GeoKrom/NTUA-Mechatronic-Systems-course/Project/Images/Τροχοφόρο_4.jpg

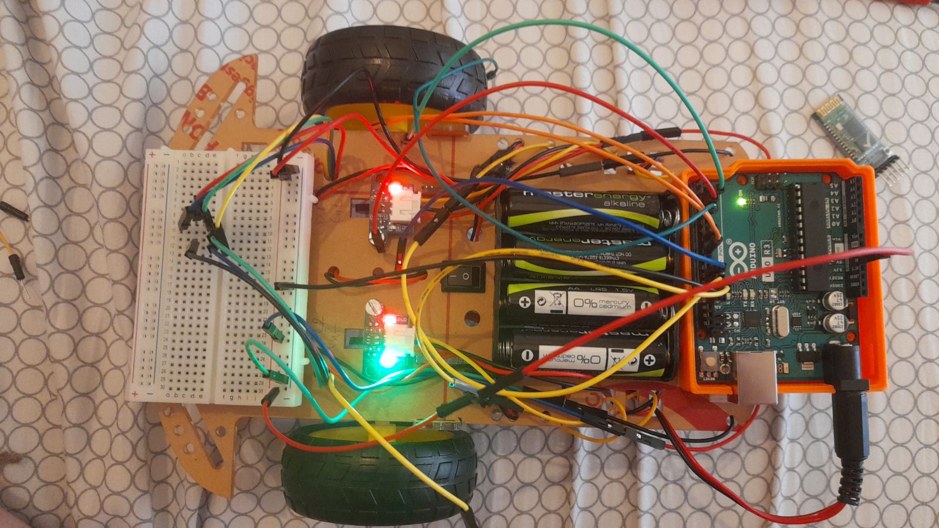
Project/Images/Τροχοφόρο_4.jpg
