GeoKrom/NTUA-Mechatronic-Systems-course/Project/Images/Τροχοφόρο_3.jpg

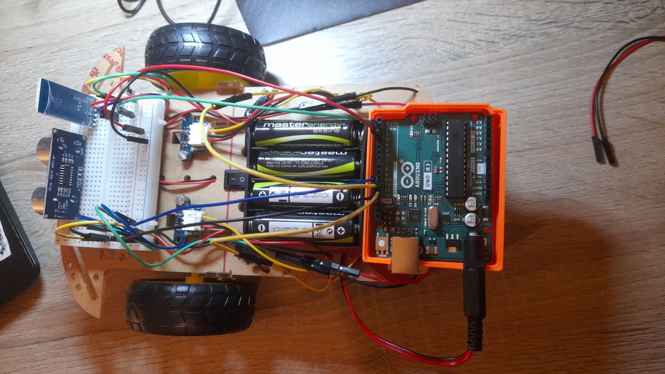
Project/Images/Τροχοφόρο_3.jpg
