GeoKrom/NTUA-Mechatronic-Systems-course/Project/Images/diagrams.pptx

PWM Enable Signal

Arduino

+

−

e

L298N Driver

DC Motors

ω_(dc)

Plant

θ

v,ω

Encoders

Εντολές από Βραχίονα

Sonar

## Slide 2

Bluetooth

Driver PCA 9685

Arduino

MG90S Micro Servo Motors

θ_(ms)

Plant

p_E

Εντολές Ταχύτητας Οχήματος

Εντολές

Εντολές Θέσεις βραχίονα

Bluetooth

Joystick

Εντολές προς Τροχοφόρο

Forward Kinematics

## Slide 3

v,ω

q

q

v_d ,ω_d

+

−

e

PID
Controller

F_Σ , Μ_Σ

Dynamics

Kinematics
∫

θ

## Slide 4

ω_(r,d)

+

−

PID
Controller

DC
Motor 1

n

ω_r

Encoder 1

q_d

v_d ,ω_d

Inverse
Kinematics

Compute
ω_r , ω_l

Compute
v, ω

Unicycle
Model

q

PID
Controller

ω_l

ω_(l,d)

+

−

DC
Motor 2

n

Encoder 2
