GeoKrom/NTUA-Mechatronic-Systems-course/Project/Παρουσίαση Εργασίας Μηχανοτρονικά Συστήματα.pdf

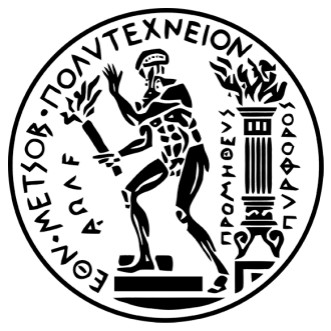
[picture p3: figure]

## Τηλεχειρισμός Κινητού Ρομποτικού Βραχίονα

ΔΠΜΣ Συστήματα Αυτοματισμού

Μηχανοτρονικά Συστήματα

Ομάδα 2:
Γεώργιος Κασσαβετάκης
Άγγελος Κουσάνας
Κωνσταντίνος Μανώλης

Ομάδα 6:
Γεώργιος Κρομμύδας
Λάμπης Παπακώστας

Μηχανοτρονικά Συστήματα, Δευτέρα 22 Μαΐου 2017

# Δομή Παρουσίασης

1. Κίνητρο
2. Σχεδιασμός
3. Κατασκευή Επιμέρους Συστημάτων
4. Συγχώνευση Κατασκευών
5. Αποτελέσματα
6. Εμπόδια - Δυσκολίες
7. Συμπεράσματα
ΟΜΆΔΕΣ 2 - 6 | 2

# 1. Κίνητρο

- Εξοικείωση με την εκπαιδευτική πλατφόρμα Arduino και μηχανοτρονικών συστημάτων.
- Εφαρμογή και αφομοίωση μεθοδολογιών που αποκτήθηκαν κατά τη φοίτηση στο παρόν ΔΠΜΣ.
- Μηχανοτρονικές έννοιες.
- Ανάπτυξη λογισμικού σε RTOS.
- Θεωρία Ελέγχου.
- Εξοικείωση με ρομποτικές διατάξεις.
- Καθορισμός προδιαγραφών συστήματος (υλικά, κόστη, κατανομή χρόνου).

# Ρομποτικός Βραχίονας

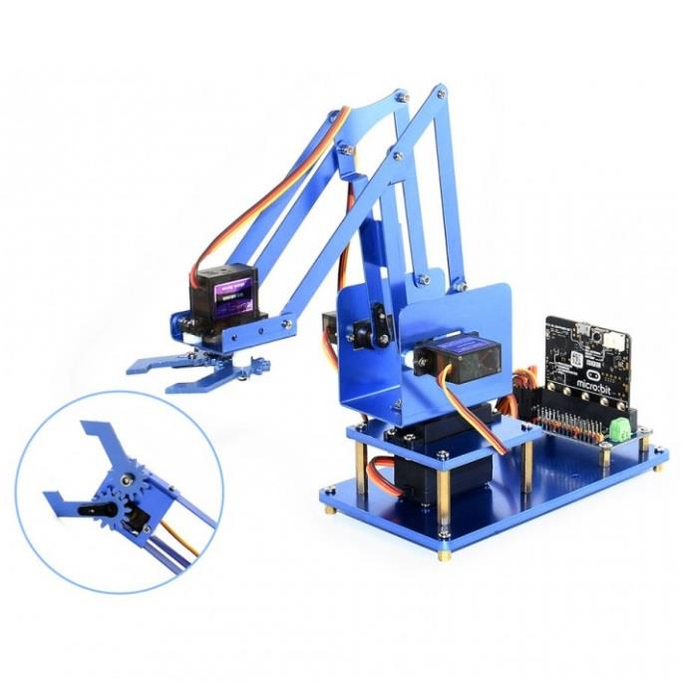
[picture p4: figure]

•Μηχανισμός τεσσάρων μελών

- Τέσσερις (4) servo – κινητήρες

•Τελικό στοιχείο δράσης

•Τηλεχειρισμός με bluetooth

•Έλεγχος στο χώρο των αρθρώσεων

•Έλεγχος στον καρτεσιανό χώρο

# Τροχοφόρο Ρομπότ

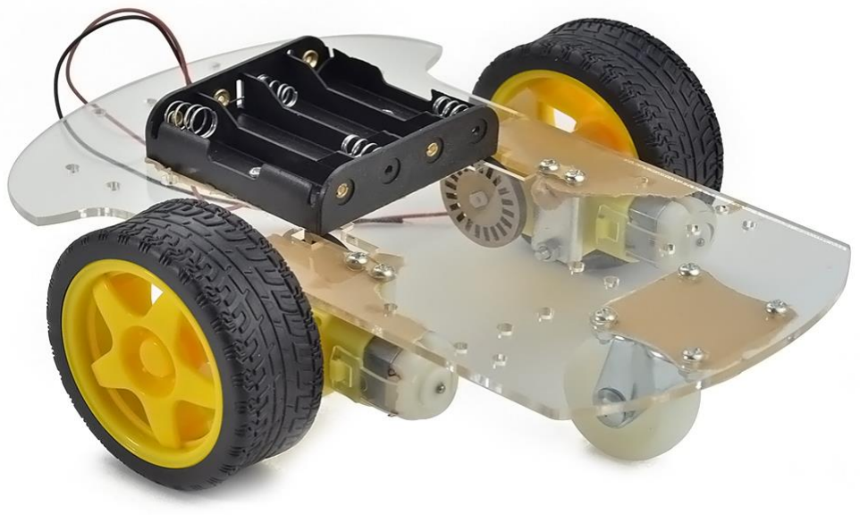
[picture p5: figure]

- Unicycle Model.
- Αποτελείται από δύο DC κινητήρες με

μειωτήρα.

- Σκελετός από ακριλικό υλικό.
- Χρήση Encoder για έλεγχο ταχύτητας.
- Χρήση Ultra Sonar για ανίχνευση

εμποδίων.

# Υλικό Ρομποτικού Βραχίονα

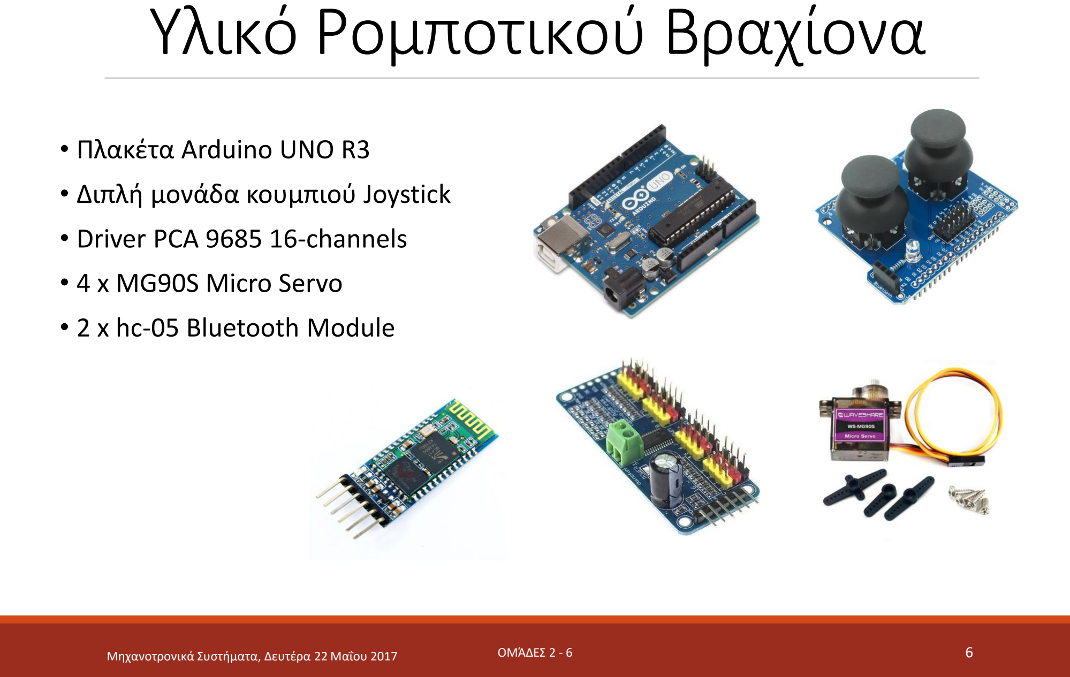
[picture p6: page 6]

- Πλακέτα Arduino UNO R3
- Διπλή μονάδα κουμπιού Joystick
- Driver PCA 9685 16-channels
- 4 x MG90S Micro Servo
- 2 x hc-05 Bluetooth Module

# Υλικό Τροχοφόρου

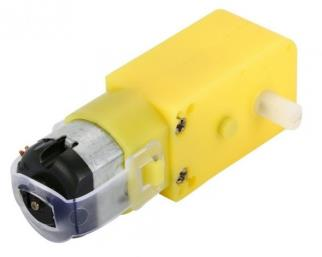
[picture p7: figure]

- Πλακέτα Arduino Uno Rev 3.
- Dual Motor Driver Module L298N.

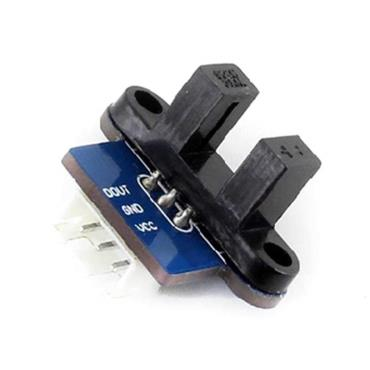
[picture p8: figure]

- 2xDC Gear Motor TT - 125 RPM.

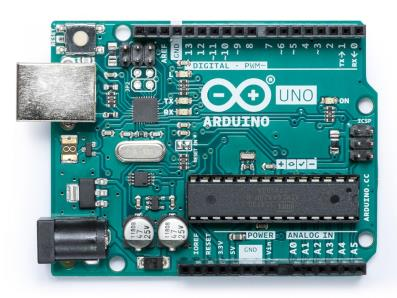
[picture p9: figure]

- 2xWaveshare Photo Interrupter Sensor.

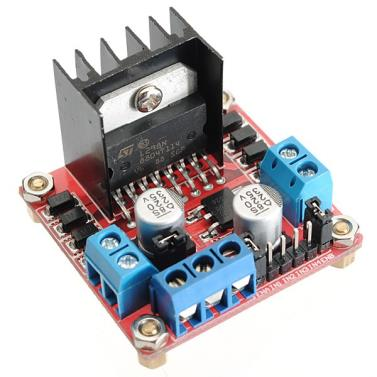
[picture p10: figure]

- Ultrasonic Sensor - Ranging Detector 2 -

400cm HC-SR04.

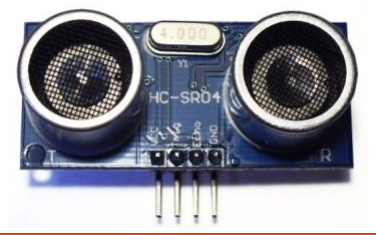
[picture p11: figure]

# 2.Σχεδιασμός

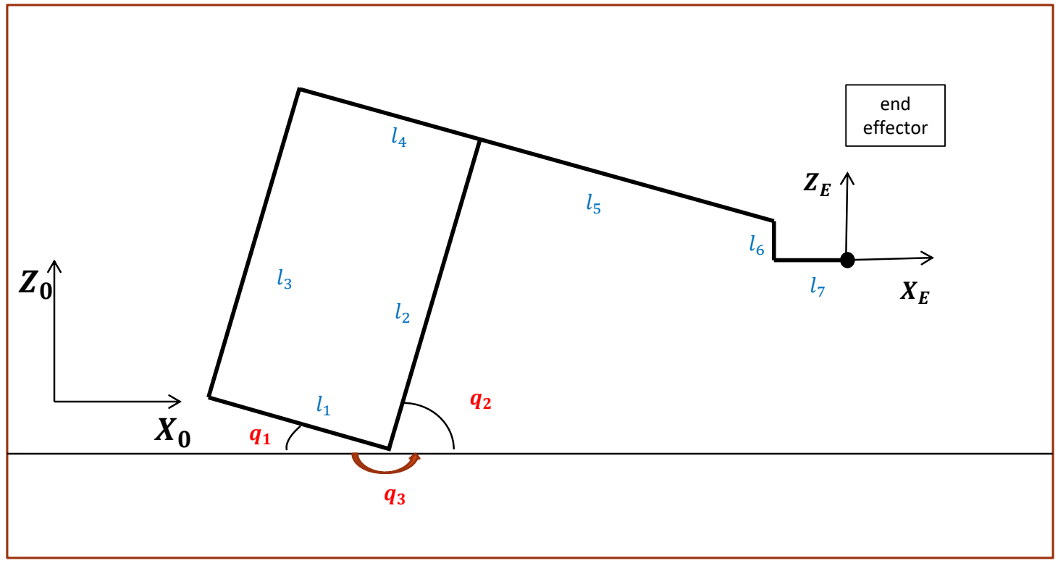
[picture p12: figure]
end effector

# Μοντελοποίηση Ρομποτικού Βραχίονα

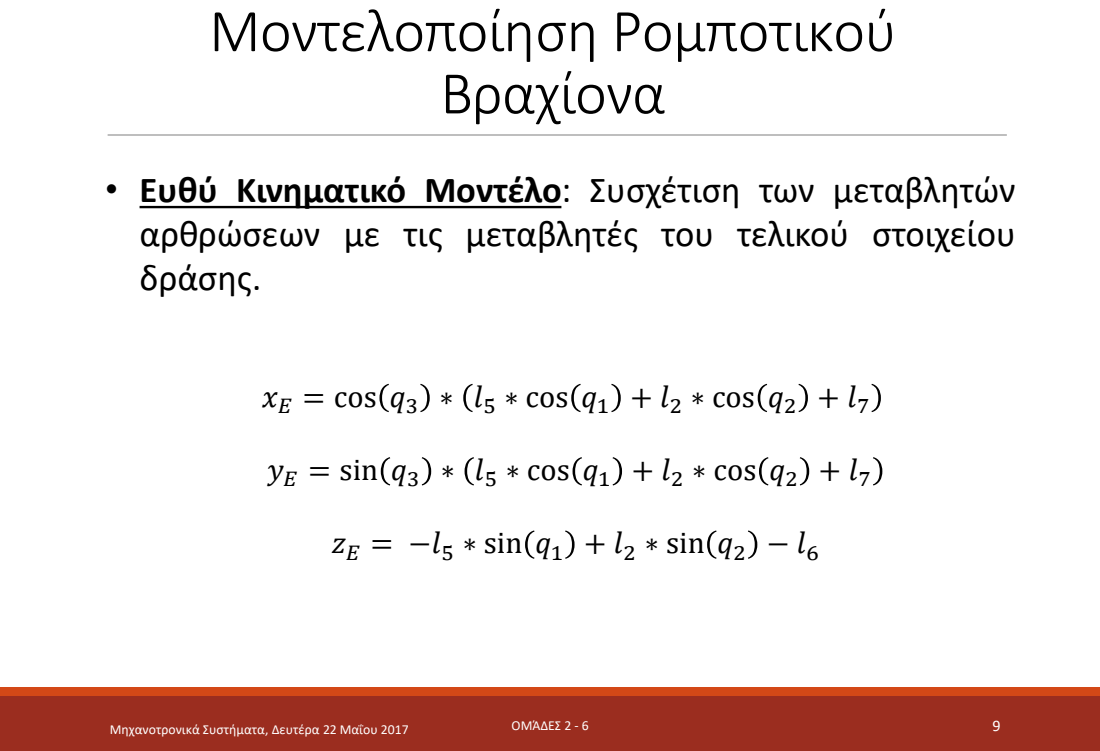
[picture p13: page 9]

• Ευθύ Κινηματικό Μοντέλο: Συσχέτιση των μεταβλητών
αρθρώσεων με τις μεταβλητές του τελικού στοιχείου
δράσης.

xE = cos q3 ∗ l5 ∗ cos q1 + l2 ∗ cos q2 + l7

yE = sin q3 ∗ l5 ∗ cos q1 + l2 ∗ cos q2 + l7

zE = −l5 ∗ sin q1 + l2 ∗ sin q2 − l6

# Μοντελοποίηση Ρομποτικού Βραχίονα

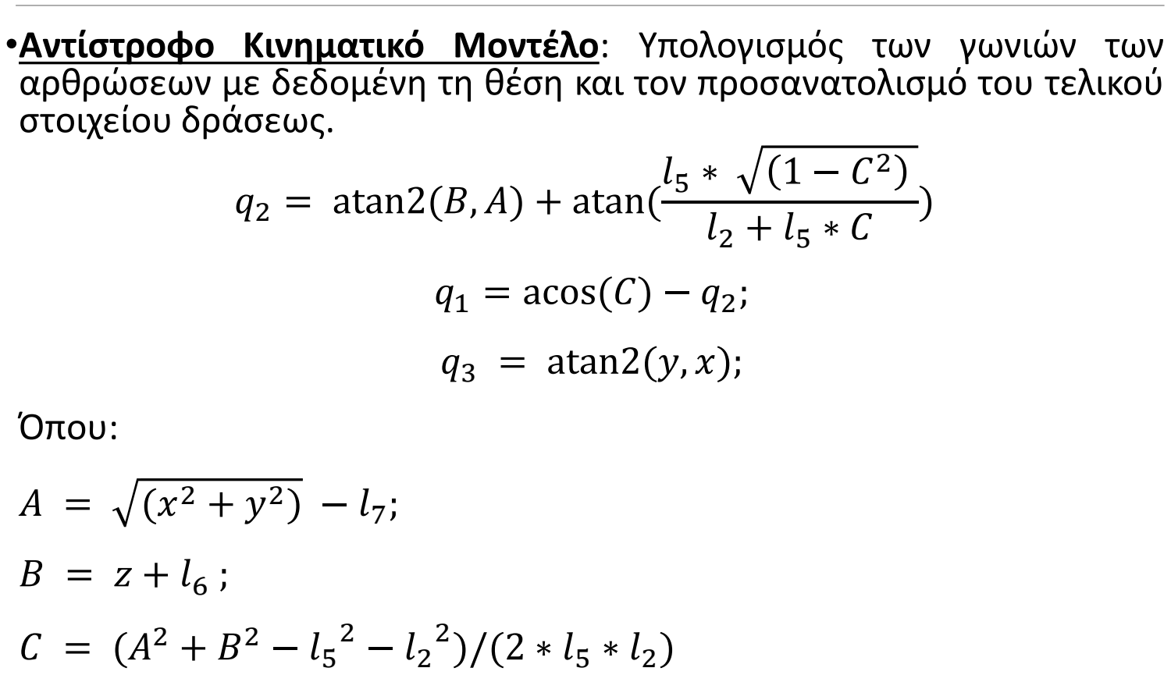
[picture p14: figure]
στοιχείου δράσεως.; q2 = atan2(B, A) + atan(; q1 = acos(C) − q2;; q3 = atan2(y, x);; Όπου:

•Αντίστροφο Κινηματικό Μοντέλο: Υπολογισμός των γωνιών των αρθρώσεων με δεδομένη τη θέση και τον προσανατολισμό του τελικού

# Pick mode

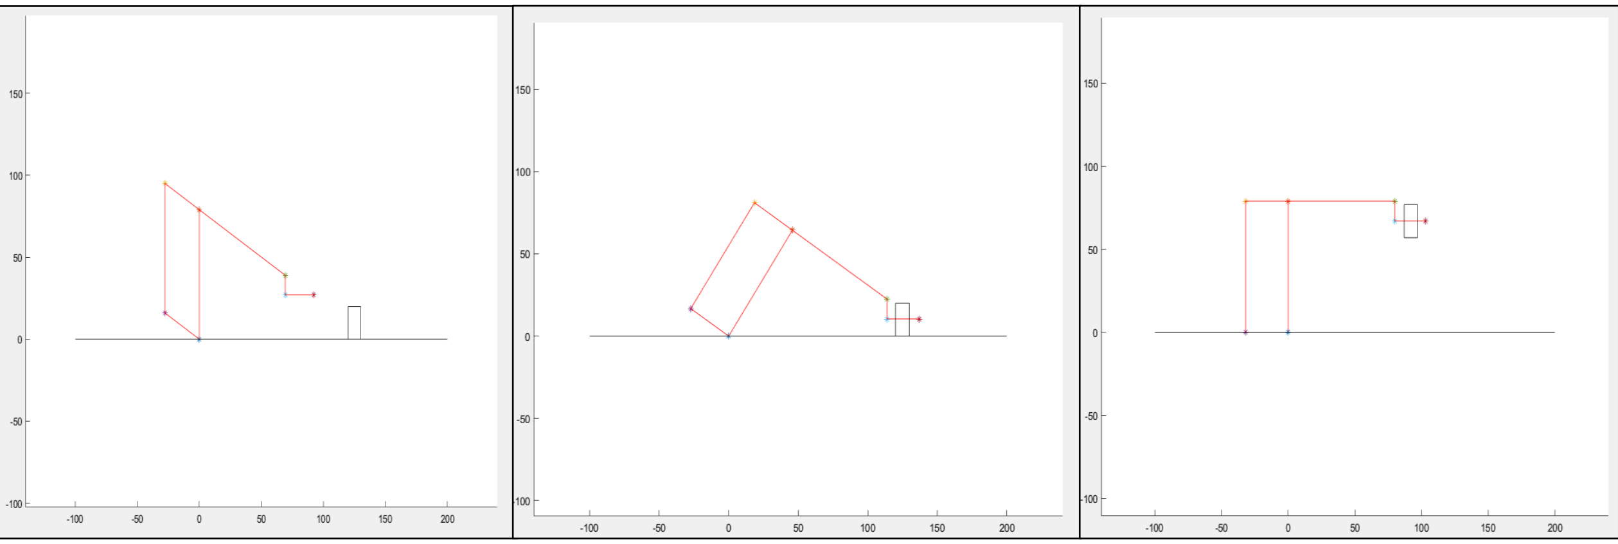
[picture p15: figure]

Αρχική θέση | Προσέγγιση αντικείμενου

Ανύψωση
αντικείμενου

# Μοντελοποίηση Οχήματος

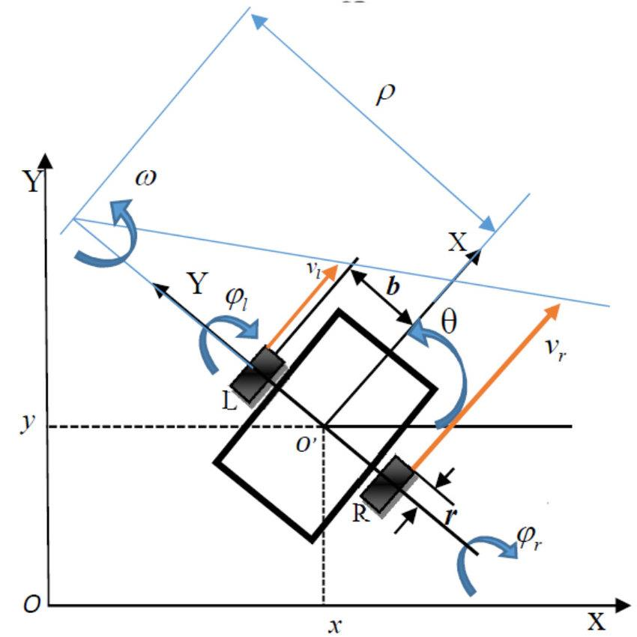
[picture p16: figure]

xሶ = vcos(θ)
yሶ = vsin(θ)
θሶ = ω

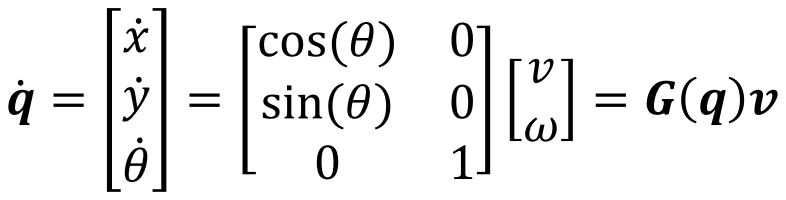
[picture p17: figure]
cos(θ) 0 sin(θ) 0

# 3. Κατασκευή Επιμέρους Συστημάτων

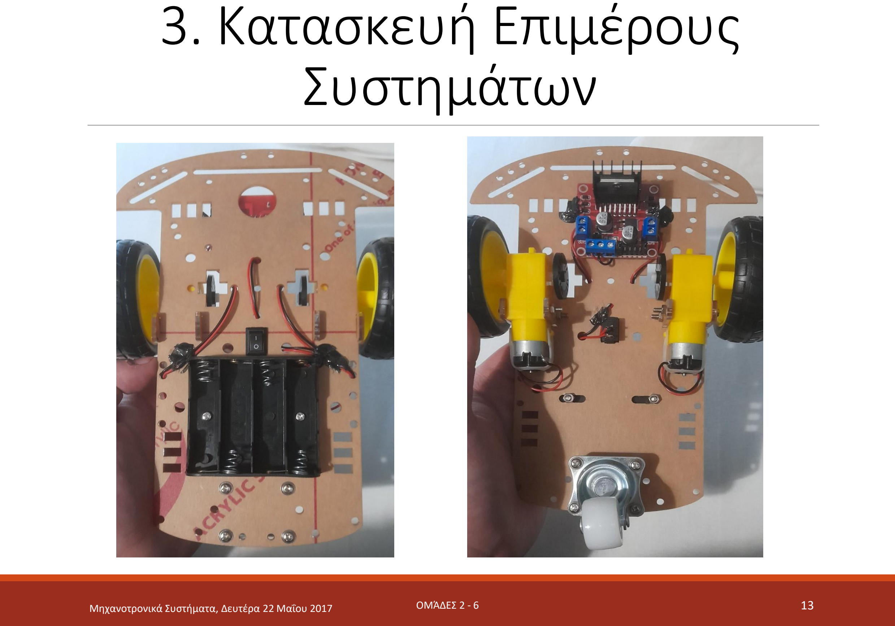
[picture p18: page 13]

# Κατασκευή Οχήματος

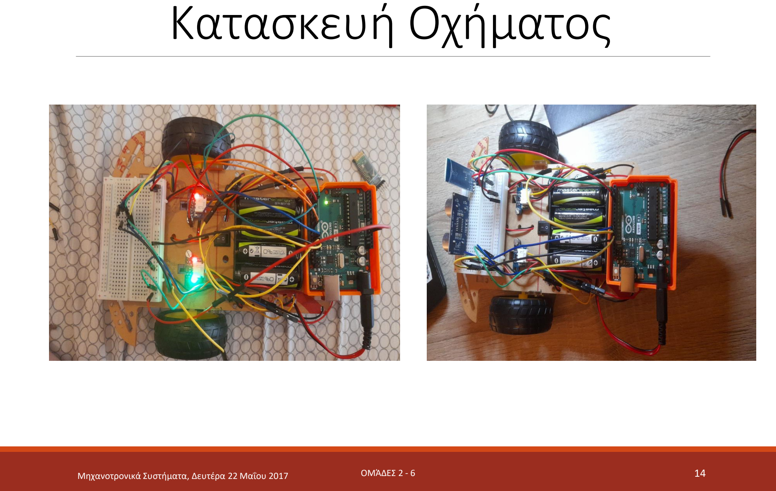
[picture p19: page 14]

# Διάρθρωση ρομποτικού βραχίονα

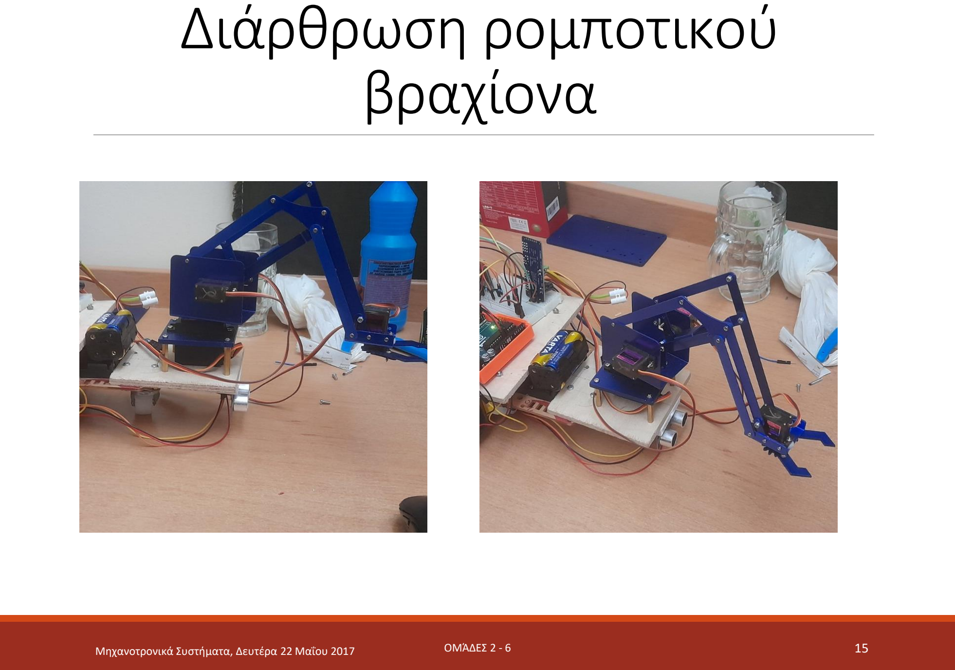
[picture p20: page 15]

# Χειριστήριο Ελέγχου

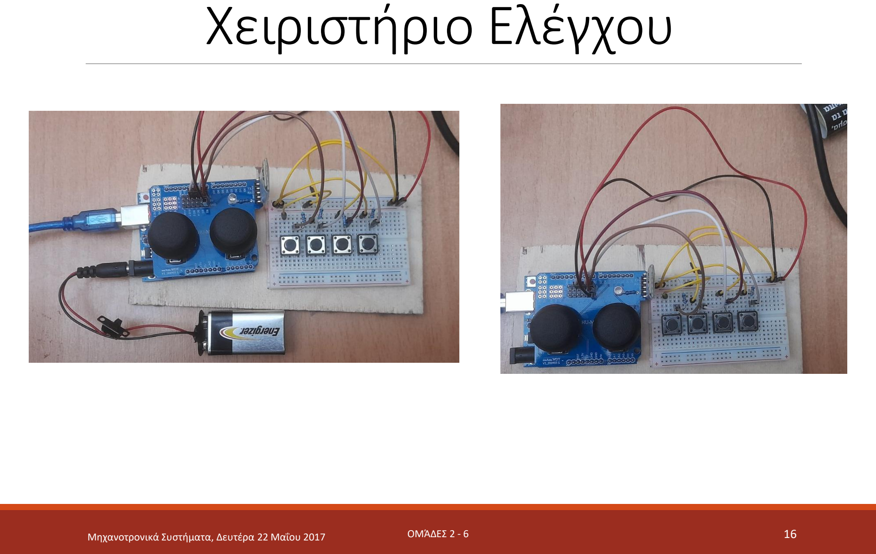
[picture p21: page 16]

# Αρχιτεκτονική Ρομποτικού Βραχίονα

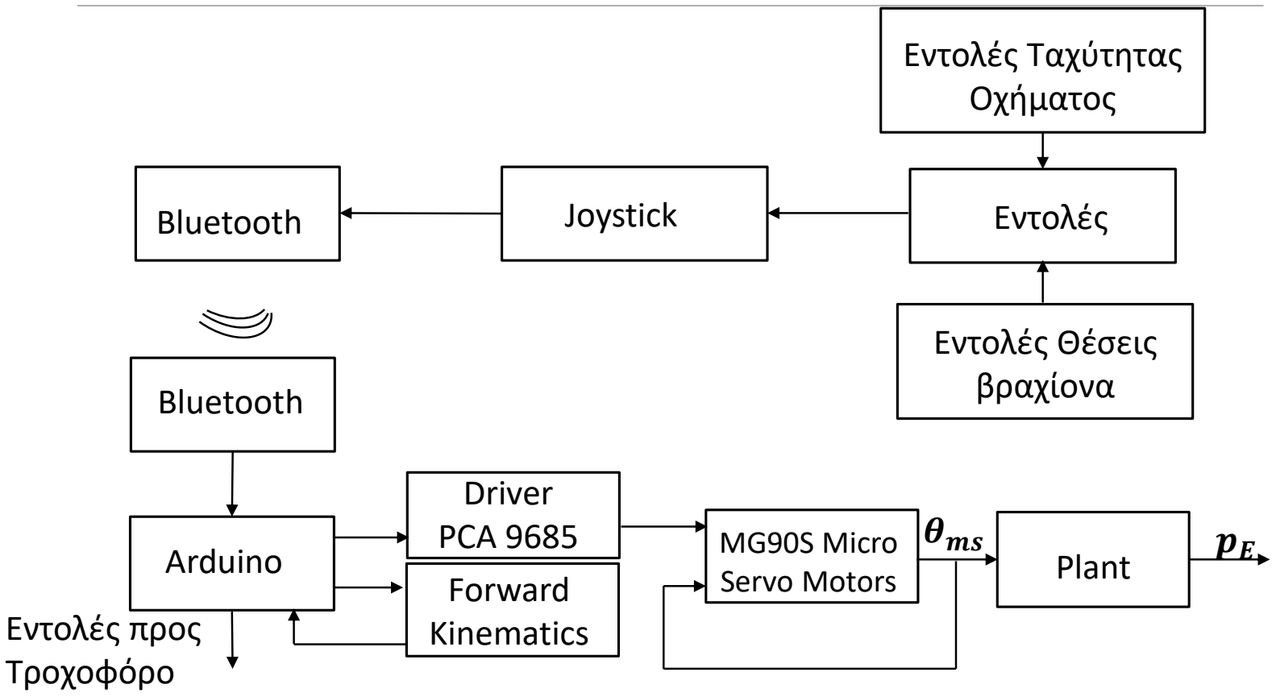
[picture p22: figure]
Arduino; Driver; PCA 9685; MG90S Micro; Servo Motors; θms; Plant; Bluetooth; Joystick; Εντολές Ταχύτητας Οχήματος; Εντολές Θέσεις βραχίονα; Εντολές; Εντολές προς Τροχοφόρο; Forward Kinematics

# Αρχιτεκτονική Τροχοφόρου

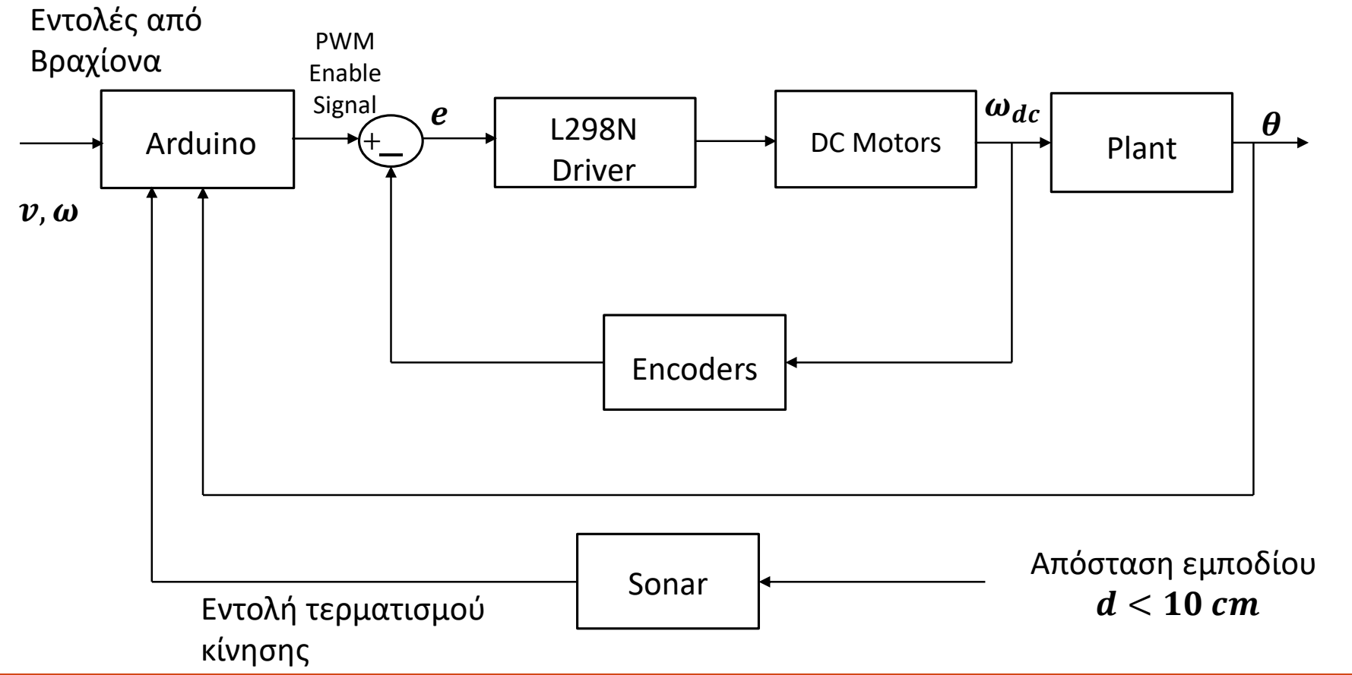
[picture p23: figure]
Arduino; Driver; Encoders; DC Motors; PWM Enable Signal +−; ωdc; Plant; Εντολές από Βραχίονα; Sonar; Απόσταση εμποδίου; Εντολή τερματισμού; κίνησης

# Αρχική Διαδικασία Υλοποίησης Κίνησης Βραχίονα

- Δημιουργία εντολών θέσεων από το χειριστήριο.
- Αποστολή μέσω Bluetooth Module με χρήση του UART

πρωτοκόλλου στο Arduino του Βραχίονα.

- Δημιουργία PWM σημάτων για την κίνηση του βραχίονα και

αποστολή στον driver.

- Εκτέλεση κίνησης από τους servo ως προς τις αρθρώσεις του

βραχίονα.

# Αρχική Διαδικασία Υλοποίησης Κίνησης Τροχοφόρου

- Δημιουργία εντολών ταχυτήτων από το χειριστήριο.
- Αποστολή μέσω Bluetooth Module με χρήση του UART

πρωτοκόλλου στο Arduino του Βραχίονα.

- Σειριακή επικοινωνία μεταξύ των δύο Arduino για την μετάδοση

της πληροφορίας στο τροχοφόρο.

- Δημιουργία PWM σημάτων για την κίνηση του τροχοφόρου και

αποστολή στον driver.

- Εκτέλεση της κίνησης από τους κινητήρες και ανάγνωση

ταχύτητας από encoders.

# 4. Συγχώνευση Συστημάτων

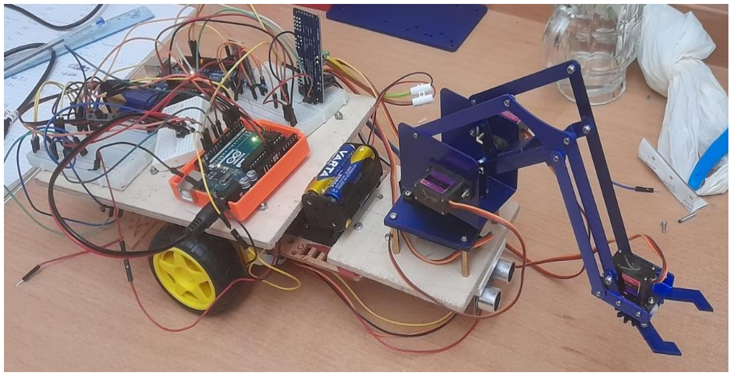
[picture p24: figure]

# Διάταξη Κινητού Ρομποτικού Βραχίονα

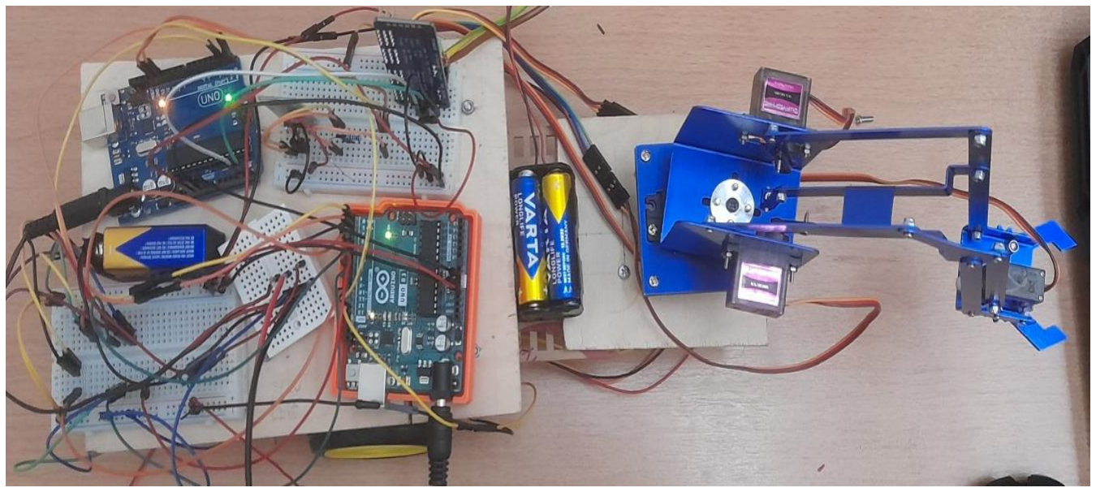
[picture p25: figure]

# Τελική Διαδικασία Υλοποίησης Κίνησης

- Κοινή χρήση τηλεχειρισμού – τηλεκατεύθυνσης.
- Με κατάλληλο πάτημα πλήκτρων, υπάρχει αλλαγή στον τηλεχειρισμό

του βραχίονα με το όχημα και αντίστροφα.

- Κατά την λειτουργία ΒΡΑΧΙΟΝΑ, υπάρχει δυνατότητα
- Κίνηση στον χώρο αρθρώσεων (Joint Space).
- Κίνηση στον καρτεσιανό (Cartesian Space).
- Διεπαφή με την αρπάγη (Grasping).
- Κατά την λειτουργία ΟΧΗΜΑΤΟΣ, δυνατότητα κίνησης στο δισδιάστατο

επίπεδο κατ’ επιλογήν του χρήστη με βάσει του unicycle μοντέλου.

- Αναγνώριση αντικειμένου από αισθητήρα τύπου Sonar.

# 5. Αποτελέσματα

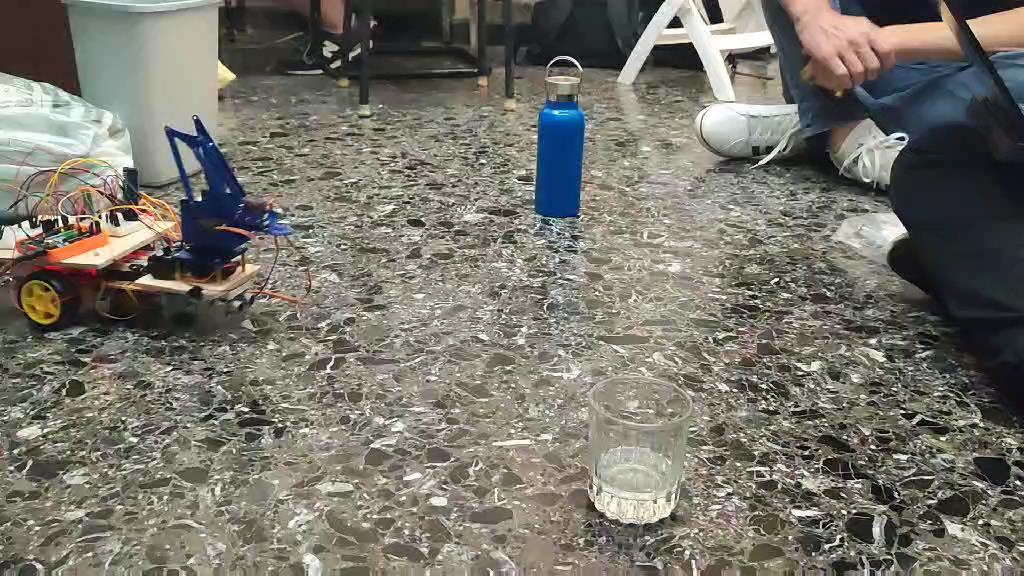
[picture p26: figure]

# Εκτέλεση Λειτουργίας Ρομποτικού Βραχίονα

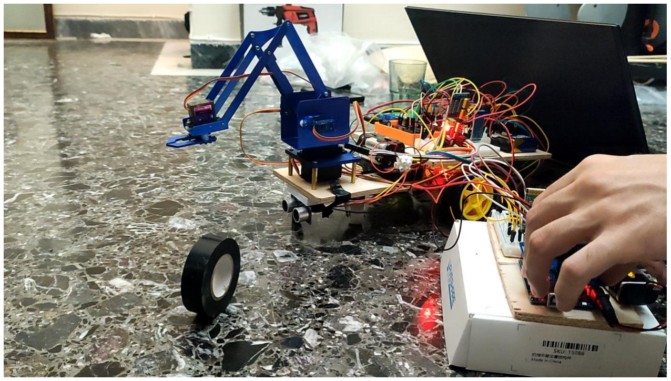
[picture p27: figure]

# Εκτέλεση Λειτουργίας Συνολικού Συστήματος

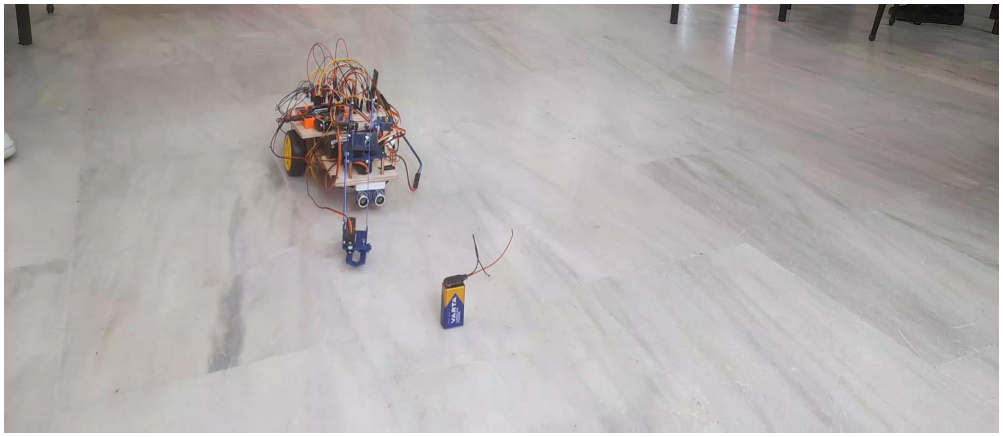
[picture p28: figure]

# 6. Εμπόδια - Δυσκολίες

- Σχετικά με τον ρομποτικό βραχίονα υπήρξαν οι εξής δυσκολίες:
- Περιορισμοί κατασκευής, έλλειψη ρουλεμάν, έλλειψη εδράνων κύλισης.
- Ο άξονας του αγκώνα απαιτεί μεγαλύτερη ροπή από αυτή που παρέχει ο servo.
- Οι μπαταρίες που χρησιμοποιήθηκαν εξαντλούνταν γρήγορα. Δημιουργία προβλημάτων στα ηλεκτρολογικά και ηλεκτρονικά εξαρτήματα.
- Σχετικά με το όχημα υπήρχε πρόβλημα στην διάταξη των εξαρτημάτων πάνω στον περιορισμένο χώρο του αμαξιού.
- Η επικοινωνία του τηλεχειριστηρίου με τον βραχίονα και το όχημα αποδείχθηκε ιδιαίτερα δύσκολη και προβληματική.

# 7. Συμπεράσματα

- Ο εκτιμώμενος χρόνος υλοποίησης είχε απόσταση με τον πραγματικό χρόνο υλοποίησης.
- Οι RC servo είναι αναξιόπιστοι.
- Οι επικοινωνίες με την χρήση Bluetooth έχουν μεγάλες καθυστερήσεις μετάδοσης.

•Οι αλληλεγχόμενες επικοινωνίες (Bluetooth με UART) δημιουργούν μεγάλες και απρόβλεπτες καθυστερήσεις.

- Η σταθερή και επαρκής παροχή ισχύος επηρεάζει την απόδοση και την ορθή λειτουργία των κινητήρων και του συστήματος συνολικά.
- Η πρακτική υλοποίηση επηρεάζεται σηματνικά από παραμέτρους που συχνά αμελούνται κατά την θεωρητική μελέτη.

# Σας Ευχαριστούμε!!

Ερωτήσεις;
