GeoKrom/NTUA-Mechatronic-Systems-course/Project/Images/circuit.pdf

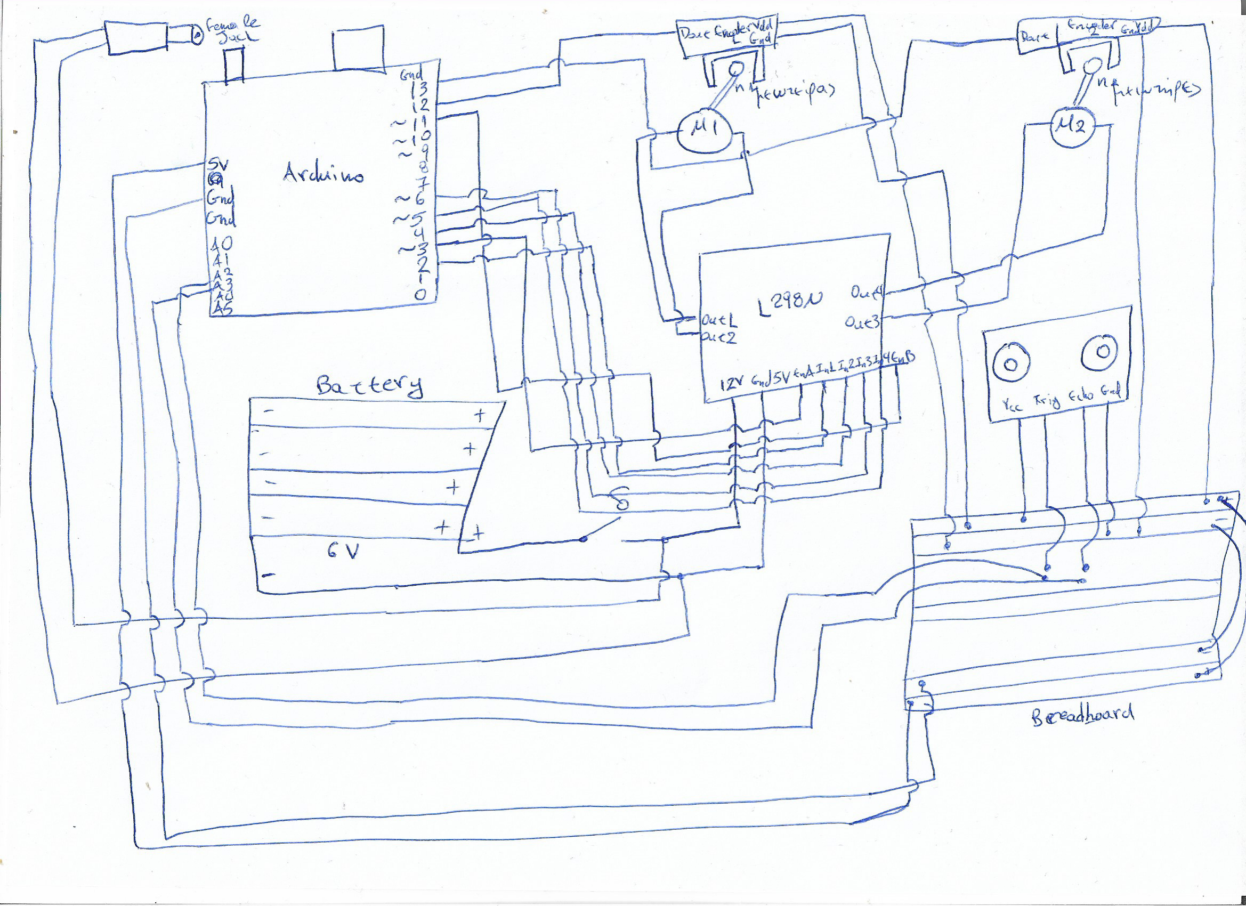
[picture p68: page 1]
