GeoKrom/NTUA-Mechatronic-Systems-course/Exercises/Exercise-2/Άσκηση-2.pdf

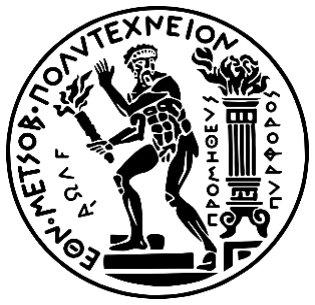
[picture p69: figure]

### Εθνικό Μετσόβιο Πολυτεχνείο

### Δ.Π.Μ.Σ. Συστήματα Αυτοματισμού

### Κατεύθυνση Β:

### Συστήματα Αυτομάτου Ελέγχου και Ρομποτικής

### Μεταπτυχιακό Μάθημα:

### Μηχανοτρονικά Συστήματα

### Δεύτερη Άσκηση

### Όνομα Φοιτητή – Α.Μ.:

### Γεώργιος Κρομμύδας – 02121208

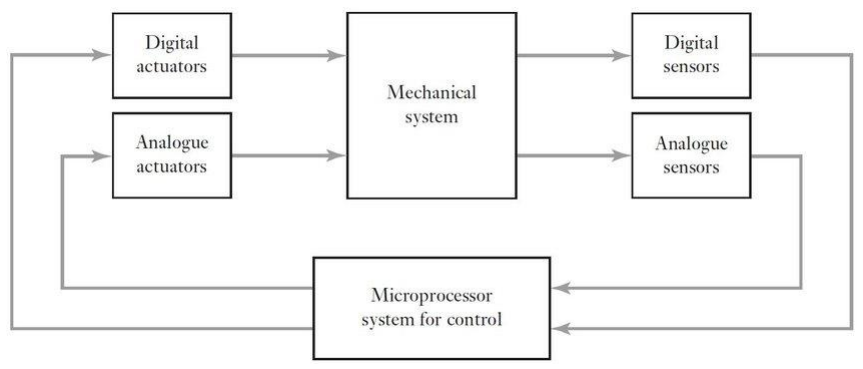
[picture p70: figure]

ΑΘΗΝΑ

2023

2204: Μηχανοτρονικά Συστήματα | Δεύτερη Άσκηση | Ακ. Έτος 2022 - 2023
Σ ε λ ί δ α 2 | 17

# Πίνακας περιεχομένων

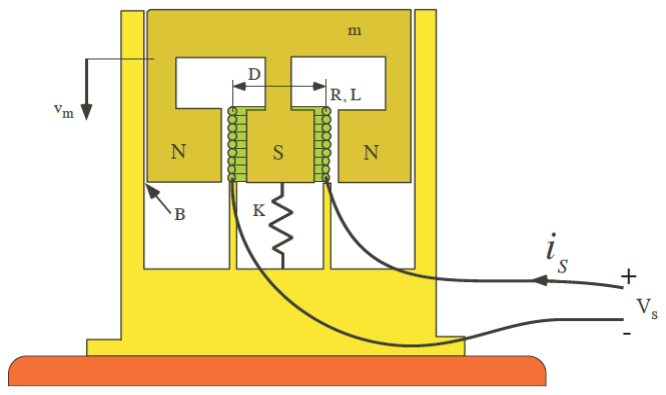
[picture p71: figure]

Σ ε λ ί δ α 3 | 17

## Εισαγωγή

Μας δίνεται μια διάταξη ενός ζυγού ταχείας απόκρισης, (βλ. Σχήμα 1). Αυτός αποτελείται

από μια κινούμενη μαγνητική βάση μάζας m που ολισθαίνει κατακόρυφα και στηρίζεται

σε ένα ελατήριο σκληρότητας, σταθεράς Κ. Περιμετρικά της κινούμενης βάσης υπάρχει

λίπανση η οποία δημιουργεί ιξώδης τριβή με συντελεστή ιξώδους B. Στο κάτω μέρος της

βάσης παρατηρούμε πως υπάρχει ένα ακίνητο πηνίο φωνής το οποίο χαρακτηρίζεται

από μία αντίσταση R και μία αυτεπαγωγή L. Κατά την λειτουργία του το πηνίο ασκεί μια

δύναμη στην μαγνητική βάση η οποία εξαρτάται από το ρεύμα που διαρρέει το πηνίο.

Σχήμα 1. Ζυγός ταχείας απόκρισης

Το παραπάνω σύστημα θα μοντελοποιηθεί δύο φορές με διαφορετική είσοδο. Στο

πρώτο μοντέλο υπάρχει ένας ενισχυτής τάσης που εφαρμόζει τάση στο πηνίο και στο

δεύτερο θα υπάρχει ένας ενισχυτής ρεύματος που θα εφαρμόζει ρεύμα στο πηνίο. Στον

πίνακα 1 παρατηρούμε τις παραμέτρους του συστήματος. Με βάση αυτά τα στοιχεία θα

μοντελοποιήσουμε και θα απαντήσουμε στα αντίστοιχα ερωτήματα.

Παράμετροι Συστήματος | Τιμή
R | 4 Ω
L | 0,001 H
m | 0.5 kg
k | 10000 N/m
B | 5 Ns/m
kc | 5 N/A

Πίνακας 1. Παράμετροι συστήματος ζυγού ταχείας απόκρισης

Σ ε λ ί δ α 4 | 17

## Μοντελοποίηση – 1η

Έστω ότι θεωρούμε ως είσοδο μία τάση Vs η οποία παρέχεται στο πηνίο του συστήματος

από έναν ενισχυτή τάσης (βλ. σχήμα 1). Θα αναπτύξουμε το μοντέλο με βάση αυτή την

είσοδο.

### Ερώτημα – 1ο

Εφαρμόζεται ως είσοδο μια τάση Vs στο πηνίο με αυτεπαγωγή L. Το πηνίο διεγείρεται και

δημιουργείται ρεύμα iL

. Γνωρίζουμε πως σε ένα πηνίο περιγράφεται από την εξής σχέση:

diL
dt

=

1
L

VL

(1.1.1)

Το ρεύμα που δημιουργείται από το πηνίο, δημιουργεί μια δύναμη FL η οποία

ασκείται στην μάζα m με αποτέλεσμα να την κινεί. Ο τύπος της δίνεται από την σχέση:

FL = kc

iL

(1.1.2)

Επίσης, κατά την εφαρμογή της τάσης στο πηνίο, δημιουργείται ένας βρόχος

μεταξύ των κυκλωματικών στοιχείων. Καθώς το πηνίο έχει στο εσωτερικό του μία

αντίσταση R και μία αυτεπαγωγή L σε σειρά, τότε χρησιμοποιείται ο δεύτερος νόμος του

Kirchhoff (Νόμος Τάσεων). Επίσης, υπάρχει και μία τάση μετάδοσης στο μηχανικό

υποσύστημα. Αυτή η τάση δημιουργείται κατά την κίνηση του συστήματος και είναι

ανάλογη της ταχύτητας της μάζας. Η τάση αυτή οφείλεται στην αρχή διατήρηση της

ενέργειας, έτσι ώστε η ισχύς του ηλεκτρικού συστήματος να μεταφερθεί στο μηχανικό

υποσύστημα. Επομένως ισχύει:

Vs = VL + iLR + V1 = VL + iLR + kcvm | (1.1.3)

Έχουμε ολοκληρώσει με το ηλεκτρικό σύστημα του ζυγού. Το επόμενο βήμα είναι

να εξετάσουμε το μηχανικό σύστημα. Παρατηρούμε πως η μάζα m είναι συνδεδεμένη με

ένα ελατήριο στην βάση της. Κατά την κίνηση της μάζας, το ελατήριο θα

παραμορφώνεται με αποτέλεσμα να ασκεί μια δύναμη FK αντίθετα για να επαναφέρει

την μάζα στην αρχική της θέση. Αυτή η δύναμη μεταβάλλεται με ρυθμό:

ḞK = Kvm | (1.1.4)

Σ ε λ ί δ α 5 | 17

όπου vm είναι η ταχύτητα που αναπτύσσει το σώμα κατά την κίνηση. Επιπλέον,

γνωρίζουμε ότι η μάζα υπόκειται σε ιξώδης τριβή, με συντελεστή B, καθώς υπάρχει

λίπανση στο εσωτερικό χώρο του ζυγού. Οπότε, η δύναμη αυτή που θα δημιουργείται

κατά την κίνηση θα είναι:

FB = Bvm | (1.1.5)

Τέλος, όταν το σύστημα του ζυγού θα ξεκινήσει να κινείται, τότε θα

δημιουργείται μια δύναμη Fm στην μάζα ώστε να εκτελείται η κίνηση. Αυτή η δύναμη

περιγράφεται στοιχειωδώς από τον δεύτερο νόμο του Newton. Οπότε:

Fm = mv̇m | (1.1.6)

Επίσης, η δύναμη αυτή είναι και αποτέλεσμα των υπόλοιπων δυνάμεων που

εμφανίζονται κατά την κίνηση της μάζας m και έχει αντίθετη φορά. Δηλαδή ισχύει ότι:

Fm = −FK − FB − FL | (1.1.7)

### Ερώτημα – 2ο

Το σύστημα του ζυγού αναλύεται σε δύο υποσυστήματα. Σε ένα ηλεκτρικό και σε ένα

μηχανικό. Το ηλεκτρικό σύστημα αποτελείται στην ουσία από μία αντίσταση και από μία

αυτεπαγωγή σε σειρά. Οπότε δημιουργείται το ρεύμα iL το οποίο είναι ίδιο και στα δύο

κυκλωματικά στοιχεία. Επομένως, γνωρίσουμε πως η τάξη του υποσυστήματος αυτού

είναι 1. Στο μηχανικό σύστημα, γνωρίζουμε πως αναπτύσσονται δυνάμεις κατά την

κίνηση της μάζας. Υπάρχει η ιξώδης τριβή και η δύναμη από το ελατήριο, οι οποίες έχουν

την ίδια διεύθυνση. Επομένως, από αυτό μπορούμε να διαπιστώσουμε πως το μηχανικό

υποσύστημα είναι τάξης 2. Αρά, το συνολικό σύστημα θα έχει τάξη:

n1 = 1 + 2 = 3

⇒ n1 = 3 | (1.2.1)

Οι μεταβλητές κατάστασης που προκύπτουν από το συγκεκριμένο σύστημα είναι

οι εξής τρεις iL

, FK και vm. Αυτές είναι οι μεταβλητές καθώς μεταβάλλονται χρονικά.

Σ ε λ ί δ α 6 | 17

### Ερώτημα – 3ο

Σε αυτό το βήμα θα αναλύσουμε τις εξισώσεις κατάστασης και θα κατασκευάζουμε την

μητρωική μορφή του συστήματος. Αντικαθιστώντας την σχέση (1.1.1) στην σχέση

(1.1.2) θα προκύψει το εξής αποτέλεσμα:

Vs = L

diL
dt + iLR −

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
iL −

kc
L

vm +

1
L

Vs

(1.3.1)

Βρήκαμε μία εξίσωση κατάστασης για το ρεύμα του πηνίου iL

. Εν συνεχεία, από την

σχέση (1.1.4), γνωρίζουμε ότι η δύναμη του ελατηρίου μεταβάλλεται από τον τύπο

ḞK = Kvm | (1.3.2)

Η σχέση (1.3.2) αποτελεί την δεύτερη εξίσωση κατάστασης. Τέλος, αντικαθιστούμε τις

σχέσεις (1.1.2), (1.1.5) και (1.1.7) στην (1.1.6) και θα λάβουμε την Τρίτη εξίσωση

κατάστασης:

−FK − FB − FL = mv̇m

⇒ −FK − Bvm + kc

iL = mv̇m

⇒ v̇m =

kc
m

iL −

1
m

FK −

B
m
vm | (1.3.3)

Επομένως, η μητρωική μορφή θα είναι ένα αποτέλεσμα των σχέσεων (1.3.1), (1.3.2) και

(1.3.3). Οπότε, έχουμε το εξής:

d

dt [

iL
FK
vm

] = [
−

R
L
| 0 | − kc
| | L
0 | 0 | K
kc m | −
| 1
| m | − B
| | m

] [
iL
FK
vm

] + [

1
L

0/0] Vs
(1.3.4)

### Ερώτημα – 4ο

Καθώς η έξοδος του συστήματος είναι η ταχύτητα, τότε η αλγεβρική εξίσωση στον χώρο

κατάστασης θα είναι:

y = vm = [0 0 1][

iL
FK
vm

] + [0]Vs
(1.4.1)

Σ ε λ ί δ α 7 | 17

Για να υπολογίσουμε την συνάρτηση μεταφοράς του συστήματος με έξοδο την ταχύτητα

και είσοδο την τάση, θα μεταβούμε από τον χώρο κατάστασης στον χώρο Laplace με την

εξής σχέση:

Gp

(s) = C(sI − A)

−1B + D

⇒ Gp

(s) = C(sI − A)

−1B | (1.4.2)

Οπότε το πρώτο βήμα που είναι να κάνουμε, είναι να υπολογίσουμε τον ενδιάμεσο όρο

και στη συνέχεια, να υπολογίσουμε την συνάρτηση μεταφοράς. Άρα ισχύει ότι:

(sI − A)

−1 =
[

s +

R
L

0

kc
L
0 | s | −K

−

kc m | 1
| m | s + B m]

−1

=

1
det(sI − A)

adj(sI − A)

Θα υπολογίσουμε αρχικά την ορίζουσα:

det(sI − A) = |

s +

R
L

0

kc
L
0 | s | −K

−

kc m | 1
| m | s + B
| | m
= (s +

R
L

) |

s −K
1
m

s +

B
m

| − 0 +
kc
L

0 s

−kc/m

1
m

| =

= (s +

R
L

) (s
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
Lm s

⇒ det(sI − A) = s

3 + (

B
m

+

R
L

) s

2 + (
K
m

+

BR
Lm +

kc

2
Lm) s +
RK
Lm

Το επόμενο βήμα είναι να υπολογίσουμε τον adjoint πίνακα. Οπότε έχουμε:

adj(sI − A) =

[

s −K
1
m

s +

B
m

| − |

0 −K

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
| − |
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
s −K

| − |
s +

R
L

kc
L
0 −K
s +

R
L

0
0 s
]

Τ

Σ ε λ ί δ α 8 | 17

=

[

s (s +

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
(s +

R
L

) (s +

B
m

) +

kc

2
Lm −

s +

R
L
m

−

kc
L
s | (s +

R
L
)K | s (s +

R
L

)
]

T

⇒ adj(sI − A) =

[

s (s +

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
(s +

R
L

) (s +

b
m

) +

kc

2
Lm (s +

R
L

)K

kc
m
s | −

s +

R
L
m

s (s +

R
L

)
]

Με τα παραπάνω αποτελέσματα μπορούμε να αντικαταστήσουμε στην σχέση

(1.4.2) και να βρούμε την συνάρτηση μεταφοράς του συστήματος. Επομένως, ισχύει ότι:

Gp

(s)

=

1

s

3 + (

B
m

+

R
L

) s

2 + (

K
m

+

BR + kc

2
Lm ) s +

RK
Lm

[0 0 1]

[

s (s +

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
(s +

R
L

) (s +

b
m

) +

kc

2
Lm (s +

R
L

)K

kc
m
s | −

s +

R
L
m

s (s +

R
L

)
]

[

1
L

0/0]

=

1

s

3 + (

B
m

+

R
L

) s

2 + (

K
m

+

BR + kc

2
Lm ) s +

RK
Lm

[0 0 1]

[

s (s +

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
⇒ Gp

(s) =

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
BR+kc

2
Lm )s+
RK
Lm
| (1.4.3)

### Ερώτημα – 5ο

Στο προηγούμενο ερώτημα υπολογίσαμε την συνάρτηση μεταφοράς του συστήματος για

έξοδο την ταχύτητα και είσοδο την τάση. Παρατηρούμε αρχικά πως έχουμε ένα μηδενικό

στο s = 0. Τώρα θα υπολογίσουμε τους πόλους του συστήματος. Για τον υπολογισμό των

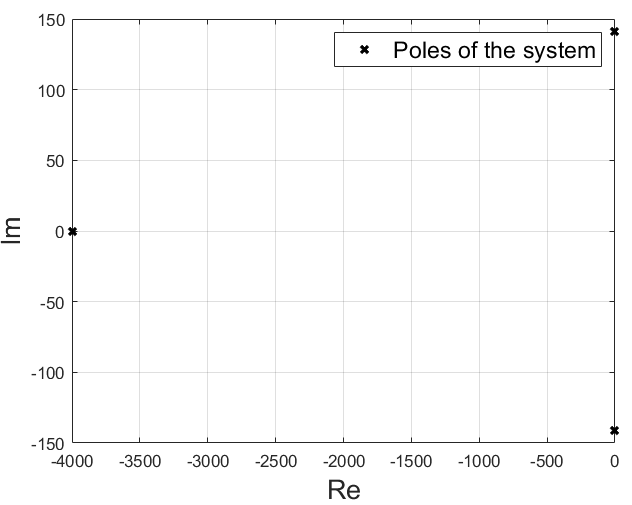
[picture p72: figure]

Σ ε λ ί δ α 9 | 17

πόλων θα θέσουμε τον παρονομαστή ίσο με μηδέν. Οι ρίζες του είναι οι πόλοι του

συστήματος. Οπότε:

s

3 + (

B
m

+

R
L

) s

2 + (
K
m

+

BR + kc

2
Lm ) s +
RK
Lm = 0

⇒ s

3 + (

5
0.5

+

4
0.001) s

2 + (

10000
0.5

+

5 ∗ 4 + 5^2
0.001 ∗ 0.5

) s +

4 ∗ 10000
0.001 ∗ 0.5

= 0

⇒ s

3 + 4.010s

2 + 110.000s + 80.000.000 = 0 | (1.5.1)

Για την λύση του παραπάνω πολυωνύμου χρησιμοποιήθηκε το MATLAB, με τις λύσεις

του να είναι οι εξής:

r1 = −3987.4

r2 = −11.278 + 141.19i

r3 = −11.278 − 141.19i

αναλυτικότερα οι πόλοι φαίνονται και στο Σχήμα 2.

Σχήμα 2. Πόλοι της συνάρτησης μεταφοράς Gp (s)

Παρατηρούμε ότι το σύστημα εμφανίζει τρεις πόλους. Από την μοντελοποίηση

διαπιστώνουμε πως ο πραγματικός πόλος εμφανίζεται λόγω του βρόχου που

εμφανίζεται κατά την εφαρμογή τάσης εισόδου. Το ηλεκτρικό υποσύστημα λειτουργεί

ως ένα RL κύκλωμα. Οι πόλοι που εμφανίζουν φανταστικό μέρος, οφείλονται από την

λειτουργεία του μηχανικού υποσυστήματος. Επειδή η μάζα m δέχεται δύναμη από το

ελατήριο το οποίο ταλαντώνει, τότε και η μάζα θα ταλαντώνει κατά την εφαρμογή της

Σ ε λ ί δ α 10 | 17

τάσης εισόδου. Επίσης, λόγω της τριβής η ταλάντωση θα αποσβένει μέχρι να

ισορροπηθεί το σύστημα.

Επειδή η ρίζα r1 του πολυωνύμου έχει πολύ μικρή τιμή δεν επηρεάζει σχεδόν

καθόλου την απόκριση του συστήματος κατά την εφαρμογή μιας εισόδου. Αυτό μας δίνει

την ευκαιρία να τον παραλείψουμε χωρίς να επηρεάζει την απόκριση του συστήματος.

Έτσι, αυτό που κάνουμε είναι να παραγοντοποιήσουμε τον παρονομαστή. Οπότε:

p(s) = (s − r1)(s − r2)(s − r3) | (1.5.2)

Ο πρώτος όρος οφείλεται στην δυναμική του ηλεκτρικού υποσυστήματος. Οπότε

μπορούμε να τον παραλείψουμε και να πέσει το σύστημα τάξη. Άρα η νέα συνάρτηση

μεταφοράς θα γίνει:

Gp

′
(s) =

kc
Lm
s (s−r2)(s−r3) | (1.5.3)

Η σχέση (1.5.3) αποτελεί την συνάρτηση μεταφοράς χωρίς τον πραγματικό πόλο.

Επαληθεύεται ότι για s = 0 έχουμε ότι το Gp

′
(0) = 0. Είναι ίδιο με το αποτέλεσμα της

συνάρτησης μεταφοράς της σχέσης (1.4.3). Δηλαδή, δεν έχει μεταβληθεί καθόλου το

κέρδος σε DC είσοδο.

## Μοντελοποίηση – 2η

Έστω πως η είσοδος στο σύστημα του ζυγού αποτελεί το ρεύμα is το οποίο επιβάλλεται

στο πηνίο από έναν ενισχυτή ρεύματος (βλ. Σχήμα 1). Θα αναπτύξουμε το μοντέλο με

αυτή την είσοδο.

### Ερώτημα – 1ο

Εφαρμόζεται ως είσοδο στο σύστημα ένα ρεύμα is

. Το ρεύμα αυτό εισέρχεται εντός της

αντίστασης και μετά εντός της αυτεπαγωγής, τα οποία είναι συνδεδεμένα σε σειρά. Έτσι,

τα ρεύματα που θα έχουν αυτά τα στοιχεία θα ισούται με το ρεύμα εισόδου.

iL = iR = is

(2.1.1)

Σ ε λ ί δ α 11 | 17

Το ρεύμα iL που δημιουργείται από το πηνίο, δημιουργεί μια δύναμη FL η οποία

ασκείται στην μάζα m με αποτέλεσμα να την κινεί. Ο τύπος της δίνεται από την σχέση:

FL = kc

iL

(2.1.2)

Έχουμε ολοκληρώσει με το ηλεκτρικό σύστημα του ζυγού. Το επόμενο βήμα είναι

να εξετάσουμε το μηχανικό σύστημα. Παρατηρούμε πως η μάζα m είναι συνδεδεμένη με

ένα ελατήριο στην βάση της. Κατά την κίνηση της μάζας, το ελατήριο θα

παραμορφώνεται με αποτέλεσμα να ασκεί μια δύναμη FK αντίθετα για να επαναφέρει

την μάζα στην αρχική της θέση. Αυτή η δύναμη μεταβάλλεται με ρυθμό:

Ḟ
K = Kvm | (2.1.4)

όπου vm είναι η ταχύτητα που αναπτύσσει το σώμα κατά την κίνηση. Επιπλέον,

γνωρίζουμε ότι η μάζα υπόκειται σε ιξώδης τριβή, με συντελεστή B, καθώς υπάρχει

λίπανση στο εσωτερικό χώρο του ζυγού. Οπότε, η δύναμη αυτή που θα δημιουργείται

κατά την κίνηση θα είναι:

FB = Bvm | (2.1.5)

Τέλος, όταν το σύστημα του ζυγού θα ξεκινήσει να κινείται, τότε θα

δημιουργείται μια δύναμη Fm στην μάζα ώστε να εκτελείται η κίνηση. Αυτή η δύναμη

περιγράφεται στοιχειωδώς από τον δεύτερο νόμο του Newton. Οπότε:

Fm = mv̇m | (2.1.6)

Επίσης, η δύναμη αυτή είναι και αποτέλεσμα των υπόλοιπων δυνάμεων που

εμφανίζονται κατά την κίνηση της μάζας m και έχει αντίθετη φορά. Δηλαδή ισχύει ότι:

Fm = −FK − FB + FL | (2.1.7)

### Ερώτημα – 2ο

Το σύστημα του ζυγού αναλύεται σε δύο υποσυστήματα. Σε ένα ηλεκτρικό και σε ένα

μηχανικό. Το ηλεκτρικό σύστημα αποτελείται στην ουσία από μία αντίσταση και από μία

αυτεπαγωγή σε σειρά. Οπότε δημιουργείται το ρεύμα iL το οποίο είναι ίδιο και στα δύο

κυκλωματικά στοιχεία. Καθώς το ρεύμα iL

ισούται με το ρεύμα εισόδου, τότε δεν υπάρχει

κάποιος ρυθμός που το μεταβάλλει. Συνεπώς η τάξη του είναι 0. Στο μηχανικό σύστημα,

γνωρίζουμε πως αναπτύσσονται δυνάμεις κατά την κίνηση της μάζας. Υπάρχει η ιξώδης

τριβή και η δύναμη από το ελατήριο, οι οποίες έχουν την ίδια διεύθυνση. Επομένως, από

Σ ε λ ί δ α 12 | 17

αυτό μπορούμε να διαπιστώσουμε πως το μηχανικό υποσύστημα είναι τάξης 2. Αρά, το

συνολικό σύστημα θα έχει τάξη:

n2 = 0 + 2 = 2

⇒ n2 = 2 | (2.2.1)

Οι μεταβλητές κατάστασης που προκύπτουν από το συγκεκριμένο σύστημα είναι

οι εξής δύο FK και vm. Αυτές είναι οι μεταβλητές καθώς μεταβάλλονται χρονικά.

### Ερώτημα – 3ο

Σε αυτό το βήμα θα αναλύσουμε τις εξισώσεις κατάστασης και θα κατασκευάζουμε την

μητρωική μορφή του συστήματος. Αντικαθιστώντας την σχέση (2.1.1) στην σχέση

(2.1.2) θα προκύψει το εξής αποτέλεσμα:

FL = kc

is

(2.3.1)

Η σχέση αυτή θα χρησιμοποιηθεί στην δεύτερη εξίσωση κατάστασης. Εν συνεχεία, από

την σχέση (2.1.4), γνωρίζουμε ότι η δύναμη του ελατηρίου μεταβάλλεται από τον τύπο

ḞK = Kvm | (2.3.2)

Η σχέση (2.3.2) αποτελεί την πρώτη εξίσωση κατάστασης. Τέλος, αντικαθιστούμε τις

σχέσεις (2.3.1), (2.1.5) και (2.1.7) στην (2.1.6) και θα λάβουμε την δεύτερη εξίσωση

κατάστασης:

−FK − FB + FL = mv̇m

⇒ −FK − Bvm − kc

is = mv̇m

⇒ v̇m =

kc
m

is −

1
m

FK −

B
m
vm | (2.3.3)

Επομένως, η μητρωική μορφή θα είναι ένα αποτέλεσμα των σχέσεων (2.3.1), (2.3.2) και

(2.3.3). Οπότε, έχουμε το εξής:

[

ḞK
v̇m

] = [

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
] + [

0
kc
m

]is
(2.3.4)

Σ ε λ ί δ α 13 | 17

### Ερώτημα – 4ο

Καθώς η έξοδος του συστήματος είναι η ταχύτητα, τότε η αλγεβρική εξίσωση στον χώρο

κατάστασης θα είναι:

y = vm = [0 1][

FK
vm

] + [0]is
(2.4.1)

Για να υπολογίσουμε την συνάρτηση μεταφοράς του συστήματος με έξοδο την ταχύτητα

και είσοδο την τάση, θα μεταβούμε από τον χώρο κατάστασης στον χώρο Laplace με την

εξής σχέση:

Gp

(s) = C(sI − A)

−1B + D

⇒ Gp

(s) = C(sI − A)

−1B = [0 1] [

s | −K
1 m | s + B m

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
[0 1] [
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
[0 1] [
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
⇒ Gp

(s) =

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
(2.4.2)

### Ερώτημα – 5ο

Στο προηγούμενο ερώτημα υπολογίσαμε την συνάρτηση μεταφοράς του συστήματος για

έξοδο την ταχύτητα και είσοδο το ρεύμα. Παρατηρούμε αρχικά πως έχουμε ένα μηδενικό

στο s = 0. Τώρα θα υπολογίσουμε τους πόλους του συστήματος. Για τον υπολογισμό των

πόλων θα θέσουμε τον παρονομαστή ίσο με μηδέν. Οι ρίζες του είναι οι πόλοι του

συστήματος. Οπότε:

Σ ε λ ί δ α 14 | 17

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
10000
0.5

= 0

⇒ s

2 + 10s + 20000 = 0 | (2.5.1)

Οπότε οι ρίζες υπολογίζονται ως εξής:

r1,2 =

−10 ± √10² − 4 ∗ 1 ∗ 20000 2

= −5 ± 141.33i ⇒

r1 = −5 + 141,33i

r2 = −5 − 141,33i

Στην περίπτωση αυτή, το σύστημα δεν μπορεί να απλοποιηθεί περεταίρω, καθώς

η απαλοιφή πόλου θα αλλάξει την συμπεριφορά του συστήματος. Έτσι, στην περίπτωση

του ελέγχου ρεύματος οι πόλοι οφείλονται αποκλειστικά στο μηχανικό μέρος του

συστήματος, σε αντίθεση με την περίπτωση ελέγχου τάσης.

## Σύγκριση Μεθόδων Μοντελοποίησης

Αυτό που παρατηρούμε είναι πως και οι δύο μέθοδοι μοντελοποίησης είναι παρόμοιοι με

την δεύτερη να αποτελεί περίπτωση της άλλης. Θα βγάλουν τα ίδια ακριβώς

αποτελέσματα. Αυτό μπορούμε να το διαπιστώσουμε και με τα σχήματα 4 και 5.

Παρατηρούμε πως για είσοδο Vs = 10 V δημιουργείται ρεύμα iL = 2.5 A, με τις υπόλοιπες

δύο μεταβλητές κατάστασης να ταλαντώνονται. Αντίστοιχα εφαρμόζουμε ως είσοδο στο

δεύτερο μοντέλο ρεύμα is = 2.5 A, με τις μεταβλητές κατάστασης να ταλαντώνονται με

τον ίδιο τρόπο όπως και στο πρώτο μοντέλο.

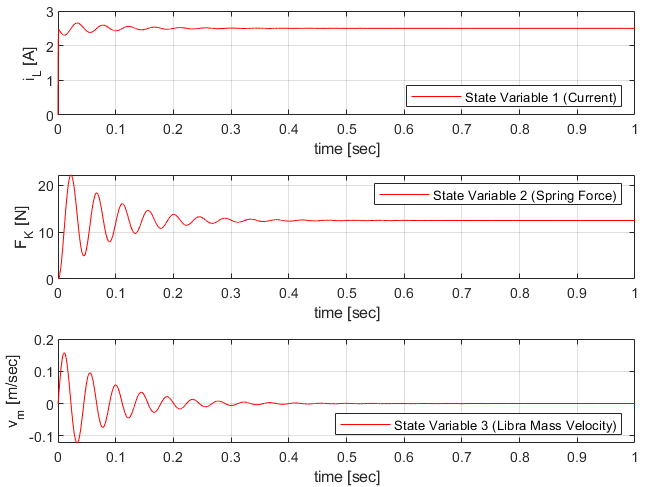
[picture p73: figure]
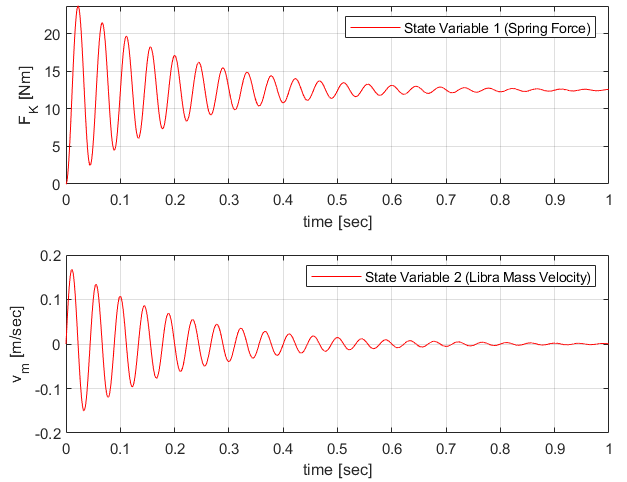
[picture p74: figure]

Σ ε λ ί δ α 15 | 17

Σχήμα 3. Απόκριση μεταβλητών κατάστασης με είσοδο 10 V

Και τα δύο μοντέλα έχουν ουσιαστικά την ίδια απόκριση. Η μόνη διαφορά είναι

στο πρώτο μοντέλο που λαμβάνουμε υπόψιν την δυναμική του ηλεκτρικού συστήματος.

Αλλά αυτό δεν επηρεάζει καθόλου την απόκριση του συστήματος καθώς ο όρος αυτός

αποσβένει ταχύτερα συγκριτικά με τις άλλες. Παρατηρούμε πως και στο σχήμα 4 και στο

σχήμα 5 οι μεταβλητές κατάστασης αποσβένουν με τον ίδιο ακριβώς ρυθμό λόγω των

μιγαδικών πόλων του συστήματος.

Σχήμα 4. Απόκριση μεταβλητών κατάστασης με είσοδο 2.5 Α

Σ ε λ ί δ α 16 | 17

## Παράρτημα

Στο παράρτημα αυτό παρατίθεται ο κώδικας σε MATLAB που παράγει τα παραπάνω

αποτελέσματα και διαγράμματα.

%% Modelling and simulation of a moving libra system %% Name: Georgios Krommydas, A.M.: 02121208

clear;
clc;

%% Parameters of System

R = 4; | % Ω
L = 0.001; | % H
m = 0.5; | % kg
K = 10000; | % N/m
B = 5; | % Ns/m
kc = 5; | % N/A
t = 0:0.0001:1; | % sec
Vs = 10; | % V
is = 2.5; | % A

%% State Space System Analysis 1

% System
A1 = [-R/L | 0 | -kc/L;
0 | 0 | K;
kc/m -1/m -B/m];

B1 = [1/L; 0; 0];

C1 = eye(3); | | % or [0 0 1];
D1 = 0;
u = 10*ones(size(t));
x0 = [0 0 0];
system = ss(A1, B1, C1, D1); system.OutputName = {'i_L','F_K','v_m'}; stateVector = lsim(system,u,t,x0);

% Convergence Value
xss1 = -inv(A1)*B1*Vs;
disp(xss1);

figure(1);
clf;
subplot(3,1,1);
plot(t, stateVector(:,1),'r-'); xlabel("time [sec]");
ylabel("i_L [A]");
grid on;
legend('State Variable 1 (Current)','Location','southeast');

subplot(3,1,2);
plot(t, stateVector(:,2),'r-');
xlabel("time [sec]");
ylabel("F_K [N]");
grid on;
legend('State Variable 2 (Spring Force)','Location','northeast');

subplot(3,1,3);
plot(t, stateVector(:,3),'r-');

Σ ε λ ί δ α 17 | 17

xlabel("time [sec]");
ylabel("v_m [m/sec]");
grid on;
legend('State Variable 3 (Libra Mass Velocity)','Location','southeast');

%% Poles of the system
p1 = [1 (B/m+R/L) (K/m +(B*R)/(L*m)) (R*K)/(L*m)];
r1 = roots(p1);

figure(2);
clf;
plot(real(r1),imag(r1),'kx','LineWidth', 2); grid;
xlabel("Re","fontsize", 16);
ylabel("Im", "fontsize", 16);
legend('Poles of the system','Location','northeast','fontsize',14);

p2 = [1 B/m K/m];
r2 = roots(p2);

figure(3);
clf;
plot(real(r2),imag(r2),'kx','LineWidth', 2); grid;
xlabel("Re","fontsize", 16);
ylabel("Im", "fontsize", 16);
legend('Poles of the system','Location','northeast','fontsize',14);

%% State Space System Analysis 2

% System
A2 = [0 K; -1/m -B/m];
B2 = [0; kc/m];
C2 = eye(2);
D2 = 0;
u2 = 2.5*ones(size(t));
x1 = [0 0];
sys2 = ss(A2,B2,C2,D2);
sys2.OutputName = {'F_K','v_m'}; stateVector2 = lsim(sys2,u2,t,x1);

% Convergence Value
xss2 = -inv(A2)*B2*is;
disp(xss2);

% Plots
figure(4);
clf;
subplot(2,1,1);
plot(t, stateVector2(:,1),'r-'); xlabel("time [sec]");
ylabel("F_K [Nm]");
grid on;
legend('State Variable 1 (Spring Force)','Location','northeast');

subplot(2,1,2);
plot(t, stateVector2(:,2),'r-');
xlabel("time [sec]");
ylabel("v_m [m/sec]");
grid on;
legend('State Variable 2 (Libra Mass Velocity)','Location','northeast'); Πίνακας 2. Κώδικας MATLAB μοντελοποίησης ζυγού ταχείας απόκρισης
