GeoKrom/NTUA-Mechatronic-Systems-course/Exercises/Exercise-1/Άσκηση-1.pdf

### Εθνικό Μετσόβιο Πολυτεχνείο

### Δ.Π.Μ.Σ. Συστήματα Αυτοματισμού

### Κατεύθυνση Β:

### Συστήματα Αυτομάτου Ελέγχου και Ρομποτικής

### Μεταπτυχιακό Μάθημα:

### Μηχανοτρονικά Συστήματα

### Πρώτη Άσκηση

### Όνομα Φοιτητή – Α.Μ.:

### Γεώργιος Κρομμύδας – 02121208


ΑΘΗΝΑ

2023

2204: Μηχανοτρονικά Συστήματα | Πρώτη Άσκηση | Ακ. Έτος 2022 - 2023
Σ ε λ ί δ α 2 | 16

# Πίνακας περιεχομένων

Σ ε λ ί δ α 3 | 16

## Εισαγωγή

Μας δίνεται ένας μηχανισμός κανόνα – πινιόν, (βλ. Σχήμα 1), το οποίο κινεί το φορείο μιας

εργαλειομηχανής CNC. Ο ενισχυτής ισχύος παρέχει οποιοδήποτε ρεύμα (iS

) στον κινητήρα

DC με σταθερά ροπής kT, ανεξάρτητα της τάσης του κινητήρα. Ο δρομέας του κινητήρα έχει

αδράνεια (Jm) και υπόκειται σε ιξώδη τριβή (Bm). Η άτρακτος είναι παραμορφώσιμη (K). Η

ακτίνα του πινιόν είναι r, και η ροπή αδράνειάς του Jp. Ο κανόνας μπορεί να θεωρηθεί

στερεό σώμα, αλλά υπόκειται σε ιξώδη τριβή B1 λόγω της «γλύστρας». Η ισοδύναμη μάζα

του κανόνα και του φορείου είναι mc

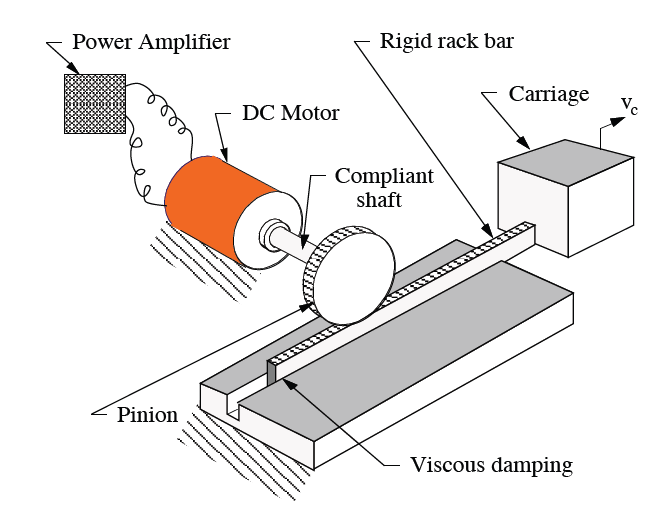
[picture p75: figure]

Σχήμα 1. Σύστημα κίνησης φορείου εργαλειομηχανής CNC

Αναλυτικότερα, μπορούμε να δούμε στον πίνακα 1 τις τιμές που έχουν οι παραπάνω

παράμετροι του συστήματος.

Παράμετροι Συστήματος | Τιμή
Bm | 0.03 Nms/rad
K | 8500 Nm/rad
Jm | 0.0075 Nms
| 2 /rad
B1 | 15 Ns/m
mc | 65 kg
r | 0.1 m
Jp | 0.0025 Nms
| 2 /rad
kT | 1 Nm/A

Πίνακας 1. Παράμετροι συστήματος κίνησης φορείου εργαλειομηχανής CNC

Με βάσει τα προαναφερθέντα θα απαντηθούν τα παρακάτω ερωτήματα.

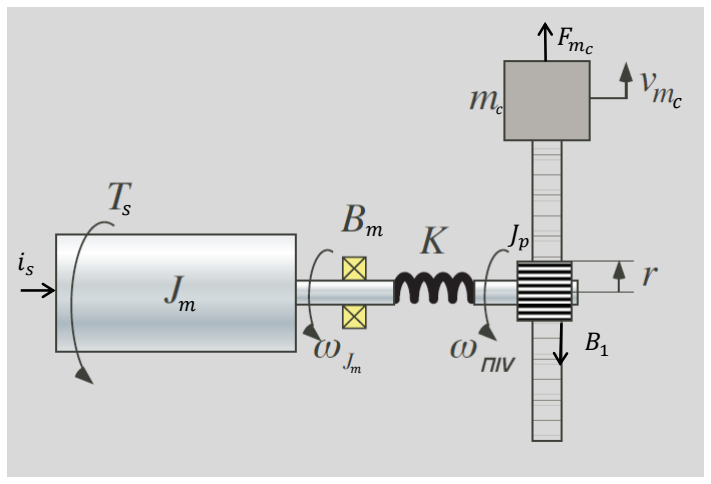
[picture p76: figure]
Fmc

Σ ε λ ί δ α 4 | 16

## Ερώτημα – 1ο

Με βάση το σχήμα 2 μπορούμε να ερμηνεύσουμε το φυσικό σύστημα. Ως είσοδο στο

σύστημα έχουμε το ρεύμα is το οποίο θα παρέχει το απαραίτητο ρεύμα στον κινητήρα, έτσι

ώστε να παραχθεί η επιθυμητή ροπή. Η ροπή Τ που παράγεται μεταδίδεται στο ρουλεμάν

με αποτέλεσμα αυτό να περιστρέφεται με γωνιακή ταχύτητα ωJm

. Επίσης, ο δρομέας

υπόκειται σε ιξώδη τριβή κατά την περιστροφή του με συντελεστή Bm. Η άτρακτος είναι

παραμορφώσιμη και λειτουργεί σαν ένα ελατήριο με σταθερά K. Σε αυτό το σημείο

παρατηρούμε πως η ροπή μετάδοσης δεξιά της ατράκτου ερμηνεύεται από την κίνηση που

εκτελεί το πινιόν με ροπή αδράνειας Jp καθώς και με την ροπή που δημιουργείται από τις

δυνάμεις που εφαρμόζονται στο πινιόν. Οι δυνάμεις αυτές οφείλονται αρχικά στην τριβή

που δημιουργείται κατά την περιστροφή του πινιόν με την μπάρα, με συντελεστή B1, και

στην δύναμη που ασκεί το φορείο κατά την κίνησή του. Τέλος, ως έξοδο του συστήματος

έχουμε την ταχύτητα του φορείου vmc

Σχήμα 2. Φυσικό μοντέλο συστήματος κίνησης φορείου εργαλειομηχανής CNC

Αρχικά, ο κινητήρας δέχεται από τον ενισχυτή ισχύος ρεύμα is

, επομένως η ροπή

που θα παράγεται από τον κινητήρα για να μεταδοθεί στο υπόλοιπο σύστημα θα είναι:

Ts = kTis

(1.1)

Στη συνέχεια , το αριστερό άκρο του δρομέα που συνδέεται με τον κινητήρα, θα αναπτύξει

ροπή:

Σ ε λ ί δ α 5 | 16

TJm = Jmω̇Jm

(1.2)

Επιπλέον, γνωρίζουμε πως ο δρομέας υπόκειται σε ιξώδη τριβή, οπότε θα δημιουργείται και

η αντίστοιχη ροπή:

TB = BmωJm

(1.3)

Επιπλέον, στον δρομέα υπάρχει και η άτρακτος που λειτουργεί σαν ελατήριο. Οπότε:

Τ̇
K = KωK | (1.4)

Στη συνέχεια, η ροπή που δημιουργείται από τον δρομέα μεταδίδεται στο πινιόν το

οποίο περιστρέφεται με γωνιακή ταχύτητα ωπιν. Καθώς το πινιόν περιστρέφεται στην

ράμπα, υπόκειται σε ιξώδης τριβή με ροπή:

TB1 = B1vmc

r | (1.5)

όπου η γραμμική ταχύτητα vmc

είναι η ταχύτητα του φορείου. Τέλος, το φορείο εκτελεί

μεταφορική κίνηση και δέχεται δύναμη:

Fmc = mcv̇mc | (1.6)

Τέλος, λόγω αυτής της δύναμης δημιουργείται ροπή στο πινιόν:

Tπιν = Fmc

r + Β1vmc

r | (1.7)

και επιπλέον η γωνιακή ταχύτητα συνδέεται με την γραμμική ταχύτητα του φορείου με τον

εξής τύπο:

ωπιν =

vmc
r

(1.8)

Έχουμε ολοκληρώσει με τις εξισώσεις των στοιχείων και το επόμενο βήμα είναι οι

εξισώσεις διασύνδεσης. Αρχικά, η ροπή που παράγεται από τον κινητήρα μεταδίδεται στον

δρομέα του κινητήρα:

Ts = TJm + TB + TK | (1.9)

Στη συνέχεια, η ροπή που δημιουργείται από την άτρακτο μεταδίδεται στο πινιόν

με αποτέλεσμα η συνολική ροπή στο πινιόν να είναι:

ΤK = Jpω̇πιν + Τπιν | (1.10)

Σ ε λ ί δ α 6 | 16

Επίσης, το ίδιο ισχύει και για την γωνιακή ταχύτητα. Η γωνιακή ταχύτητα της

ατράκτου και το δρομέα δημιουργούν την γωνιακή ταχύτητα του πινιόν. Οπότε:

ωΚ = ωJm − ωπιν | (1.11)

## Ερώτημα – 2ο

Συνδυάζοντας τις σχέσεις (1.1), (1.2) και (1.9) θα λάβουμε το εξής αποτέλεσμα:

ω̇Jm =

1
Jm

TJm =

1
Jm

(Ts − BmωJm − TK) =

kT
Jm

is −

Bm
Jm

ωJm −

1
Jm

TK

⇒ ω̇Jm = −

Bm
Jm

ωJm −

1
Jm

TK +

kT
Jm

is

(2.1)

Το επόμενο βήμα είναι να παραχθούν και οι υπόλοιπες αλγεβρικές εξισώσεις. Στη

συνέχεια της ανάλυσης, θα χρησιμοποιήσουμε τις σχέσεις (1.4), (1.8) και (1.11). Άρα ισχύει

ότι:

Τ̇

K = KωK = Κ(ωJm − ωπιν) = Κ (ωJm −

vmc
r

)

⇒ Τ̇
K = ΚωJm −

Κ
r

vmc

(2.2)

Τέλος, θα κάνουμε χρήση των σχέσεων (1.6), (1.7), (1.10) και θα πάρουμε το εξής

αποτέλεσμα:

ΤK = Jp

v̇mc
r

+ mcv̇mc

r + Β1vmc

r

⇒ ΤK − Β1vmc

r = (

Jp
r

+ mcr) v̇mc

⇒ v̇mc = (

Jp
r

+ mcr)

−1
ΤK − (

Jp
r

+ mcr)

−1
Β1rvmc

⇒ v̇mc = (

Jp
r

+ mcr)

−1
ΤK − Β1 (

Jp
r

2 + mc)

−1
vmc

(2.3)

Σ ε λ ί δ α 7 | 16

Συνδυάζοντας τις σχέσεις (2.1), (2.2) και (2.3) θα λάβουμε την εξής μητρωική μορφή:
[

ω̇Jm
Τ̇
K
v̇mc

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
K | 0 | −

K
r
0 (

Jp
r
| + mcr)

−1
− Β1 (
| | Jp
r
| | 2 + mc)

−1
]

[

ωJm
ΤK
vmc

] + [

kT
Jm

0/0] is
(2.4)

## Ερώτημα – 3ο

Καθώς έχουμε ότι η έξοδος είναι η ταχύτητα του φορείου vmc

, τότε θα προκύψει η εξής

αλγεβρική εξίσωση στον χώρο κατάστασης:

y = vmc = [0 0 1] [

### ωJm

ΤK

### vmc

] + [0]is
(3.1)

Έστω ότι έχουμε μηδενικές αρχικές συνθήκες στο σύστημα. Έτσι, θα μπορέσουμε

να εφαρμόσουμε τον μετασχηματισμό Laplace στις παραπάνω σχέσεις. Με αυτόν τον τρόπο

μπορούμε να βρούμε μια αλγεβρική σχέση που συνδέει αρχικά την είσοδο με την έξοδο. Στη

συνέχεια θα εφαρμόσουμε τον αντίστροφο μετασχηματισμό Laplace για να λάβουμε την

διαφορική εξίσωση που συνδέει την ταχύτητα vmc

με το ρεύμα εισόδου is

. Οπότε ισχύει ότι:

{

sΩJm = −

Bm
Jm

ΩJm −

1
Jm

TK +

kT
Jm

Is

sTK = ΚΩJm −

Κ
r

Vmc

sVmc = (

Jp
r

+ mcr)

−1
ΤK − Β1 (

Jp
r

2 + mc)

−1
Vmc

(3.2)

Η πρώτη αλγεβρική σχέση της (3.2) θα λυθεί ως προς την γωνιακή ταχύτητα ωJm

και

στη συνέχεια θα αντικατασταθεί στην δεύτερη αλγεβρική σχέση. Τέλος, η δεύτερη θα

επιλυθεί ως προς την ροπή TKκαι θα αντικατασταθεί στην τρίτη αλγεβρική σχέση. Έτσι, θα

παραχθεί η συνολική αλγεβρική εξίσωση ως προς την έξοδο και την είσοδο. Επομένως,

ισχύει ότι:

Σ ε λ ί δ α 8 | 16

sΩJm +

Bm
Jm

ΩJm = −

1
Jm

TK +

kT
Jm

Ιs

⇒ ΩJm =

1

s +

Bm
Jm

( −

1
Jm

TK +

kT
Jm

Ιs)

⇒ ΩJm = −

1
Jm
s+

Bm
Jm

TK +

kT
Jm
s+

Bm
Jm

Ιs

(3.3)

Το επόμενο βήμα είναι να αντικαταστήσουμε την (3.3) στην δεύτερη αλγεβρική

εξίσωση (3.2b). Άρα, έχουμε ότι:

sTK = ΚΩJm −

Κ
r

Vmc

⇒ sTK = K (−

1
Jm

s +

Bm
Jm

TK +

kT
Jm

s +

Bm
Jm

Ιs) −
Κ
r

Vmc

⇒ sTK = −

K
Jm

s +

Bm
Jm

TK +

KkT
Jm

s +

Bm
Jm

Is −

Κ
r

Vmc

⇒ TK =

1
(s +
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
Is −

Κ
r

# Vmc)

⇒ TK =

(s +

Bm
Jm

)

s (s +

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
Is −

Κ
r

# Vmc)

TK = −

(s+

Bm
Jm

)

Κ
r
s(s+

Bm
Jm

)+

K
Jm

Vmc +

KkT
Jm
s(s+

Bm
Jm

)+

K
Jm

Is

(3.4)

Τέλος, θα αντικαταστήσουμε την σχέση (3.4) στην (3.2c) με σκοπό την εύρεση της

αλγεβρικής εξίσωσης που χρειαζόμαστε. Έτσι, θα προκύψει ότι:

Σ ε λ ί δ α 9 | 16

sVmc = (

Jp
r

+ mcr)

−1
ΤK − Β1 (

Jp
r

2 + mc)

−1
Vmc

⇒ (s + Β1 (
J
p
r

2 + mc)

−1

)Vmc = (
J
p
r

+ mcr)

−1
(

−

(s +

Bm
Jm

)

Κ
r
s (s +

Bm
Jm

) +

K
Jm

Vmc +

KkT
Jm
s (s +

Bm
Jm

) +

K
Jm

Is
)

⇒ (s + Β1 (
Jp
r

2 + mc)

−1
) Vmc + (
Jp
r

+ mcr)

−1 (s +

Bm
Jm

)

Κ
r
| s (s + Bm Jm
) +

K
Jm

Vmc =

KkT
Jm

(

Jp
r

+ mcr)

−1

s (s +

Bm
Jm

) +

K
Jm

Is

⇒ (s (s +

Bm
Jm

) +

K
Jm

) (s + Β1 (
Jp
r

2 + mc)

−1
)Vmc + (
Jp
r

+ mcr)

−1
(s +

Bm
Jm

)

Κ
r

Vmc =

KkT
Jm

(

Jp
r

+ mcr)

−1
Is

⇒ (s
2 +

Bm
Jm

s +

K
Jm

) (s + Β1 (
Jp
r

2 + mc)

−1
)Vmc + (
Jp
r

+ mcr)

−1
(s +

Bm
Jm

)

Κ
r

Vmc =

KkT
Jm

(

Jp
r

+ mcr)

−1
Is

⇒ [s
3 + (
Bm
Jm

+ Β1 (

Jp
r

2 + mc)

−1
) s

2 + (
K
Jm

+ Β1 (

Jp
r

2 + mc)

−1 Bm
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
+ mcr)

−1

)s + Β1 (
Jp
r

2 + mc)

−1 K
Jm

+

Bm
Jm

(

Jp
r

+ mcr)

−1 Κ
r

] Vmc

=

KkT
Jm

(

Jp
r

+ mcr)

−1
Is ⇒

s

3Vmc + (
Bm
Jm

+ Β1 (

Jp
r

2 + mc)

−1
) s

2Vmc + (
K
Jm

+ Β1

Bm
Jm

(

Jp
r

2 + mc)

−1
+

Κ
r

(

Jp
r

+ mcr)

−1
) sVmc +

(Β1 (
Jp
r

2 + mc)

−1 K

Jm

+

Κ
r

(

Jp
r

+ mcr)

−1 Bm

Jm

) Vmc =
KkT
Jm

(

Jp
r

+ mcr)

−1
Is

(3.5)

Έχουμε φτάσει σε μια τελική αλγεβρική εξίσωση όπου σχηματίζεται ένα

πολυώνυμο τρίτου βαθμού πολλαπλασιασμένο με την έξοδο του συστήματος. Από αυτό

διαπιστώνουμε πως το σύστημα είναι τρίτης τάξης. Έτσι, θα μπορέσουμε να βρούμε την

διαφορική εξίσωση εφαρμόζοντας αντίστροφο μετασχηματισμό Laplace. Οπότε ισχύει ότι:

v⃛mc + (
Bm
Jm

+ Β1 (

Jp
r

2 + mc)

−1
) v̈mc + (
K
Jm

+ Β1

Bm

Jm

(

Jp
r

2 + mc)

−1
+

Κ
r

(

Jp
r

+ mcr)

−1
) v̇mc +

(Β1 (
Jp
r

2 + mc)

−1 K

Jm

+

Κ
r

(

Jp
r

+ mcr)

−1 Bm

Jm

) vmc =
KkT
Jm

(

Jp
r

+ mcr)

−1
is

(3.6)

Συνεπώς, η σχέση (3.6) που προκύπτει είναι μία γραμμική διαφορική εξίσωση

τρίτης τάξης, η οποία έχει ομογενής λύση και μερική λύση, λόγω της εισόδου is

Σ ε λ ί δ α 10 | 16

## Ερώτημα – 4ο

Όπως προέκυψε από την λύση του τρίτου ερωτήματος, έχουμε μία διαφορική εξίσωση

τρίτης τάξης. Θέλουμε να βρούμε την ομογενής λύση αυτής της εξίσωσης και την

χαρακτηριστική εξίσωση.

Το χαρακτηριστικό πολυώνυμο της παραπάνω εξίσωσης θα είναι της μορφής

a3r

3 + a2r

2 + a1r + a0 = 0 | (4.1)

όπου οι συντελεστές του πολυωνύμου είναι οι συντελεστές των παραγώγων της εξόδου.

Οπότε, θα υπολογίσουμε τους συντελεστές για να βρούμε το χαρακτηριστικό πολυώνυμο.

Επομένως, ισχύει ότι:

α3 = 1

a2 =

Bm
Jm

+ Β1 (

J
p
r

2

+ mc)

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
2 + mc

⇒ a2 =

0.03
0.0075+

15
0.0025
0.01 +65

= 4+0.2298

⇒ a2 = 4.2298

a1 =

K
Jm

+

Bm
Jm

Β1 (

J
p
r

2

+ mc)

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
+ mcr)

−1

⇒ a1 =

8500
0.0075 +

0.03
0.0075

15
0.0025
0.01 + 65

+

8500
0.1
0.0025
0.1

+65 ∗ 0.1

⇒ a1 = 1.133.333,333 + 0,9192 + 13.026,8199

⇒ a1 = 1.346.361,0721

a0 = Β1 (

J
p
r

2

+ mc)

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
+ mcr)

−1
Bm
Jm

⇒ a0 = (
15
0.0025

0.01 +65)
8500

0.0075 +(

8500
0.1
0.0025
0.1

+ 65 ∗ 0.1

)
0.03
0.0075

⇒ a0 = 0,2298 ∗ 1.133.333,333 + 13.026,8199 ∗ 4

Σ ε λ ί δ α 11 | 16

a0 = 312.547,28

Συνολικά, το χαρακτηριστικό πολυώνυμο θα είναι:

r

3 + 4.2298r

2 + 1.346.361,0721r + 312.547,28 = 0 | (4.2)

Για να βρούμε την ομογενής λύση, θα πρέπει να επιλύσουμε την εξής διαφορική

εξίσωσης:

v⃛mc + (
Bm
Jm

+ Β1 (

Jp
r

2 + mc)

−1
) v̈mc + (
K
Jm

+ Β1 (

Jp
r

2 + mc)

−1 Bm
Jm

+

Κ
r

(

Jp
r

+ mcr)

−1
| ) v̇mc

+ (Β1 (
Jp
r

2 + mc)

−1 K
Jm

+

Κ
r

(

Jp
r

+ mcr)

−1 Bm
Jm

) vmc = 0

⇒ v⃛mc + 4,2298 v̈mc + 1.346.361,0721v̇mc + 312.547,28vmc = 0(4.3)

Από την ομογενής διαφορική εξίσωση θα προκύψει και η χαρακτηριστική εξίσωση η οποία

είναι η (4.2). Οι ρίζες που θα προκύψουν από την λύση της χαρακτηριστικής εξίσωσης, θα

δώσουν την μορφή της λύσης της ομογενής διαφορικής εξίσωσης. Λύνοντας το

χαρακτηριστικό πολυώνυμο της σχέσης (4.2) θα προκύψουν τρεις λύσεις. Η μία θα είναι

πραγματική με αρνητικό πρόσημο και οι υπόλοιπες δύο θα είναι συζυγείς μιγαδικές με

αρνητικό πραγματικό μέρος. Οι ρίζες που προκύπτουν είναι οι εξής:

r1 = −0.23214

r2 = λ + μi = −1.9988 + 1160.3i

r3 = λ −μi = −1.9988 − 1160.3i

Καθώς έχουμε μία πραγματική ρίζα πολλαπλότητας 1 και δύο μιγαδικές ρίζες

πολλαπλότητας 1, τότε η ομογενής λύση που θα προκύψει για το σύστημα αυτό είναι:

vmc,o

(t) = c0e

r1t + c1e

λt
cos(μt) + c2e

λt
sin(μt)

⇒ vmc,o

(t) = c0e

−0.23214t + c1e

−1.9988 t
cos(1160.3t) + c2e

−1.9988 t
sin(1160.3t) | (4.4)

Σ ε λ ί δ α 12 | 16

## Ερώτημα – 5ο

Η γενική λύση της διαφορικής εξίσωσης έχει μορφή:

vmc

(t) = vmc,o

(t) + vmc,p

(t) | (5.1)

όπου η vmc,p

(t) είναι η μερική λύση της διαφορικής εξίσωσης και βασίζεται στην είσοδο is

Ο συντελεστής της εισόδου στην διαφορική εξίσωση θα έχει τιμή:

b0 =

KkT
Jm

(

J
p
r

+ mcr)

−1
=

8500 ∗ 1

0.0075 (
1
0.0025
0.1

+ 65 ∗ 0.1

)

⇒ b0 = 173.690,94

Συνεπώς, η συνολική διαφορική εξίσωση που θα προκύψει θα είναι

v⃛mc + 4,2298 v̈mc + 1.346.361,0721v̇mc + 312.547,28vmc = 173.690,94is
(5.2)

Στην ειδική περίπτωση που έχουμε ως είσοδο το is = 5 A, τότε η διαφορική εξίσωση θα

γίνει:

v⃛mc + 4,2298 v̈mc + 1.346.361,0721v̇mc + 312.547,28vmc = 173.690,94is

⇒ v⃛mc + 4,2298 v̈mc + 1.346.361,0721v̇mc + 312.547,28vmc = 868.454,7

Καθώς έχουμε ότι η διαφορική εξίσωση ισούται με έναν αριθμό, τότε θα υποθέσουμε αρχικά

ότι η μερική λύση θα είναι της μορφής:

vmc,p

(t) = a

καθώς δεν αποτελεί λύση της ομογενής συνάρτησης. Οπότε, θα χρησιμοποιήσουμε αυτό το

αποτέλεσμα και θα το αντικαταστήσουμε στην διαφορική για να βρούμε τον συντελεστή

αυτό. Άρα ισχύει το εξής:

0+ 0 +0 + 312.547,28 ∗ α = 868.454,7

⇒ α =

868.454,7
312.547,28 = 2,779

Επομένως ισχύει ότι

vmc

(t) = c0e

−0.23214t + c1e

−1.9988 t
cos(1160.3t) + c2e

−1.9988 t
sin(1160.3t) + 2,779 (5.2)

Σ ε λ ί δ α 13 | 16

## Ερώτημα – 6ο

Έχουμε βρει την ειδική λύση για είσοδο is = 5 A. Το επόμενο βήμα είναι να υπολογίσουμε

τους συντελεστές της αναλυτικής έκφρασης. Έχουμε μηδενικές αρχικές συνθήκες στο

σύστημα. Δηλαδή:
{

vmc

(0) = 0
v̇mc
(0) = 0
v̈mc
(0) = 0

(6.1)

Υπολογίζουμε τις παραγώγους για να βρούμε τους τρεις συντελεστές:

v̇mc

(t) = −0.23214c0e

−0.23214t

+ c1

(−1.9988e

−1.9988 t
cos(1160.3t)− 1160.3e

−1.9988 t
sin(1160.3t))

+ c2

(−1.9988e

−1.9988 t
sin(1160.3t) +1160.3e

−1.9988 t
cos(1160.3t))

v̈mc

(t) = −0.0539c0e

−0.23214t

+ c1((3.9952e
−1.9988 t
cos(1160.3t) − 2,319.2e

−1.9988 t
sin(1160.3t))

+ (2,319.2e

−1.9988 t
sin(1160.3t) − 1346300e

−1.9988 t

cos(1160.3t)))

+ c2((3.9952e
−1.9988 t
sin(1160.3t) − 2319.2e

−1.9988 t
cos(1160.3t))

+ (−2319.2e

−1.9988 t
cos(1160.3t) − 1346300e

−1.9988 t

sin(1160.3t)))

⇒ v̈mc
(t) = −0.0539c0e

−0.23214t −1,346,296.0048c1e

−1.9988 t
cos(1160.3t)

+ c2

(−1,346,296.0048e

−1.9988 t
sin(1160.3) −4638.4e

−1.9988 t
cos(1160.3t))

Οπότε θα αντικαταστήσουμε τις σχέσεις της (5.3) και το αποτέλεσμα θα είναι:
{

c0 + c1 = −2.779
0.23214c0 + 1.9988c1 − 1160.3c2 = 0 0.0539c0 + 1,346,296.0048c1 + 4638.4c2 = 0

(6.2)

Λύνοντας αυτό το σύστημα τριών εξισώσεων με τρεις αγνώστους της σχέσης (6.2),

προκύπτουν οι εξής παράμετροι:

(c0
, c1

, c2

) = (−2.779002026809371, 2.02680937099213e − 06,−0.000555988519621612)

Επομένως, η ειδική λύση του προβλήματος θα είναι η εξής:

vmc

(t) = −2.779e

−0.23214t + 0.0000020268e

−1.9988 t
cos(1160.3t) +

−0.0005559e

−1.9988 t sin(1160.3t) + 2,779 | (6.3)

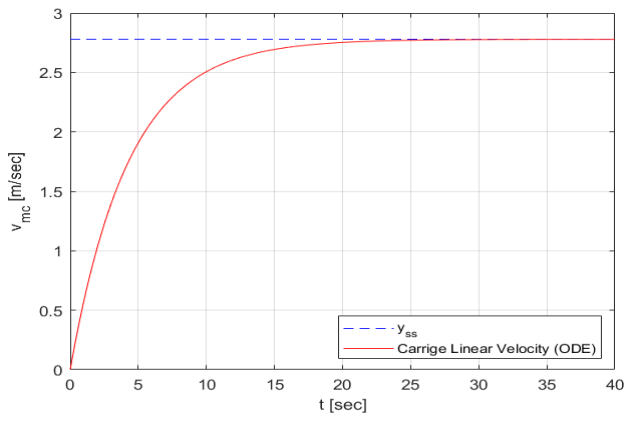
[picture p77: figure]

Σ ε λ ί δ α 14 | 16

Τέλος, μπορούμε να δούμε την απόκριση της ταχύτητας στο σχήμα 4. Το

αποτέλεσμα είναι ικανοποιητικό, καθώς βλέπουμε πως συγκλίνει στην σε μία οριακή τιμή

την yss. Η τιμή αυτή αποτελεί την μόνιμη κατάσταση του συστήματος, όταν ο χρόνος

τείνει στο άπειρο.

Σχήμα 3. Απόκριση γραμμικής ταχύτητας φορείου με είσοδο is = 5 A

Η τιμή μόνιμης κατάστασης του συστήματος θα είναι:

vmcss

= lim
t→∞

vmc

(t) = 2.779 | (6.4)

καθώς εάν πάρουμε το όριο της σχέσης (6.3), τότε μηδενίζονται τα εκθετικά και μένει μόνο

ο σταθερός όρος.

## Ερώτημα – 7ο

Έχουμε υπολογίσει τις ρίζες του χαρακτηριστικού πολυωνύμου στο ερώτημα 4. Αποδείξαμε

πως οι ρίζες του βρίσκονται στο αρνητικό μιγαδικό επίπεδο καθώς έχουν αρνητικό

πραγματικό μέρος. Έτσι, αποδεικνύεται ότι το σύστημα είναι ευσταθές. Αναλυτικότερα

φαίνονται και στο σχήμα 4.

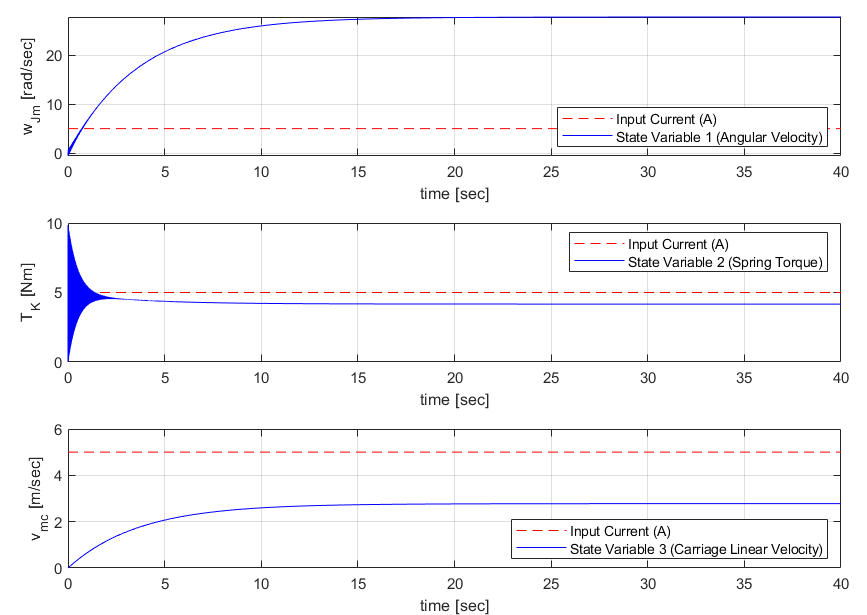
[picture p78: figure]

Σ ε λ ί δ α 15 | 16

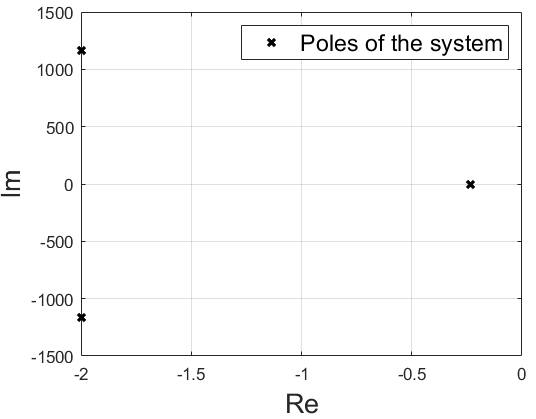
[picture p79: figure]

Σχήμα 4. Λύσεις χαρακτηριστικού πολυωνύμου στο μιγαδικό επίπεδο

Εφαρμόζοντας ρεύμα εισόδου is = 5 A στο σύστημα, δεχόμαστε τις αποκρίσεις των

μεταβλητών κατάστασης στο σχήμα 5.

Σχήμα 5. Απόκριση μεταβλητών κατάστασης με είσοδο is = 5 A

Οι αποκρίσεις που προκύπτουν στο σχήμα 5 παρουσιάζουν ταλαντώσεις κατά την

λειτουργία του συστήματος. Αυτές οι ταλαντώσεις οφείλονται στις μιγαδικές ρίζες του

χαρακτηριστικού πολυωνύμου. Μάλιστα έχουμε πολλές καθώς το φανταστικό μέρος

αποτελείται από μεγάλο αριθμό και κατ’ επέκτασιν προκύπτουν μεγάλες συχνότητες κατά

την λειτουργία του. Εμφανές παράδειγμα αυτών των ταλαντώσεων που έχει το σύστημα

παρατηρείται στην ροπή του δρομέα TK. Επιπλέον, μπορούμε να διαπιστώσουμε πως και

οι άλλες δύο μεταβλητές κατάστασης εμφανίζουν ταλαντώσεις κατά την λειτουργία του

συστήματος.

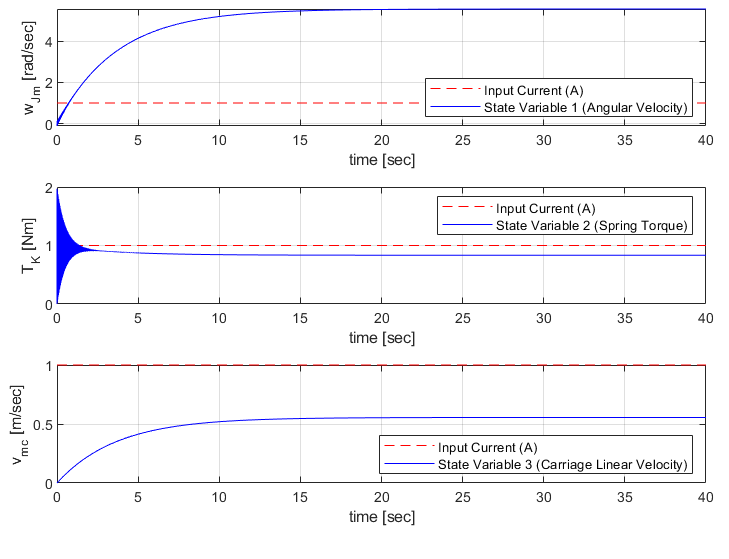
[picture p80: figure]

Σ ε λ ί δ α 16 | 16

## Ερώτημα – 8ο

Για βηματική είσοδο (is = 1 A) στο σύστημα, δεχόμαστε τις αποκρίσεις που φαίνονται στο

σχήμα 6.

Σχήμα 6. Απόκριση μεταβλητών κατάστασης με είσοδο is = 1 A

Η απόκριση σταθερής κατάστασης του σχήματος 6 δεν συμφωνεί με την απόκριση

του σχήματος 3 (ερώτημα - 6ο ή στ), καθώς η ταχύτητα στο συγκεκριμένο γράφημα

συγκλίνει περίπου στην τιμή vmcss

= 0.5557 m/sec. Ενώ του ερωτήματος 6 στην τιμή

vmcss

= 2.779 m/sec, όπως αποδείχθηκε και από την σχέση (6.4). Η διαφορετική τιμή

οφείλεται στο ρεύμα εισόδου που εισέρχεται στον κινητήρα του συστήματος.

Η απόκριση σταθερής κατάστασης των μεταβλητών κατάστασης του σχήματος 6

έχει διαφορετική τιμή συγκριτικά με αυτή του σχήματος 5. Αυτό οφείλεται στην είσοδο που

εισάγουμε στο σύστημα. Είναι λογικό με την αύξηση της εισόδου να έχουμε και μεγαλύτερη

απόκριση των μεταβλητών κατάστασης. Έτσι, η μόνιμη κατάσταση θα αλλάξει ανάλογα με

την είσοδο που επιβάλλεται στον κινητήρα.
