GeoKrom/NTUA-Mechatronic-Systems-course/Project/Images/Circuit.png

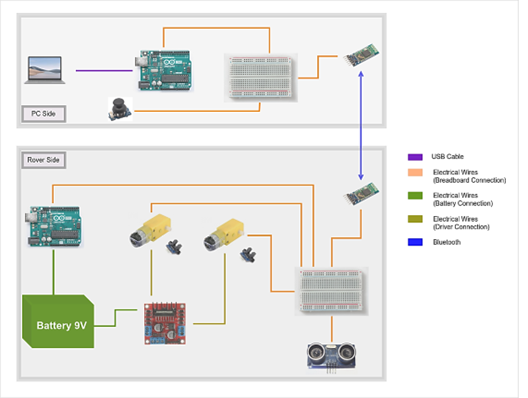
Project/Images/Circuit.png
