GeoKrom/NTUA-Mechatronic-Systems-course/Project/Images/DC Motor/7591b637-ebb4-46d0-91d0-3db6ca10906f_grobo.jpg

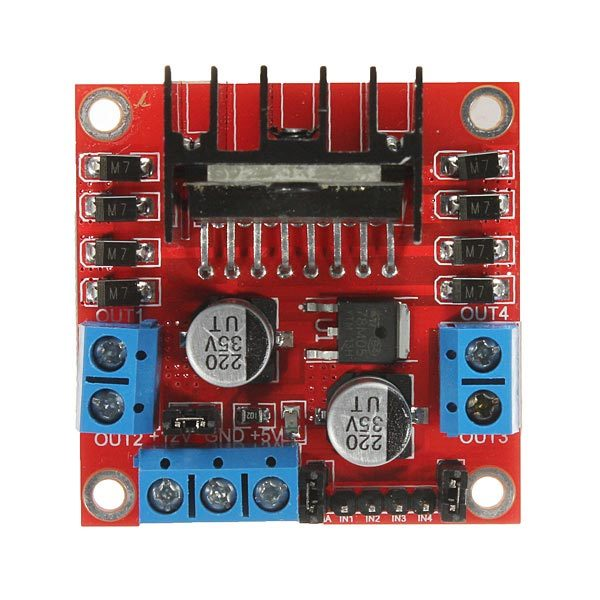
Project/Images/DC Motor/7591b637-ebb4-46d0-91d0-3db6ca10906f_grobo.jpg
