GeoKrom/NTUA-Mechatronic-Systems-course/Project/Images/DC Motor/BO-1__ONE_SIDE.jpg

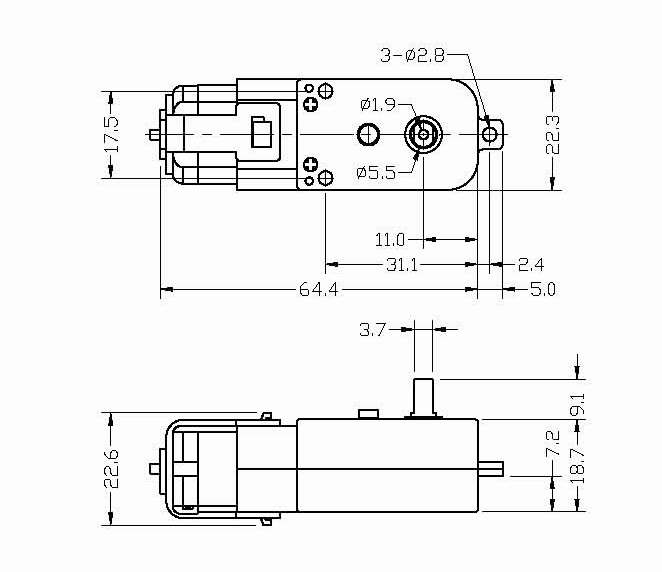
Project/Images/DC Motor/BO-1__ONE_SIDE.jpg
