GeoKrom/NTUA-Mechatronic-Systems-course/Project/Images/DC Motor/Χαρακτηριστικά DC Κινητήρα.png

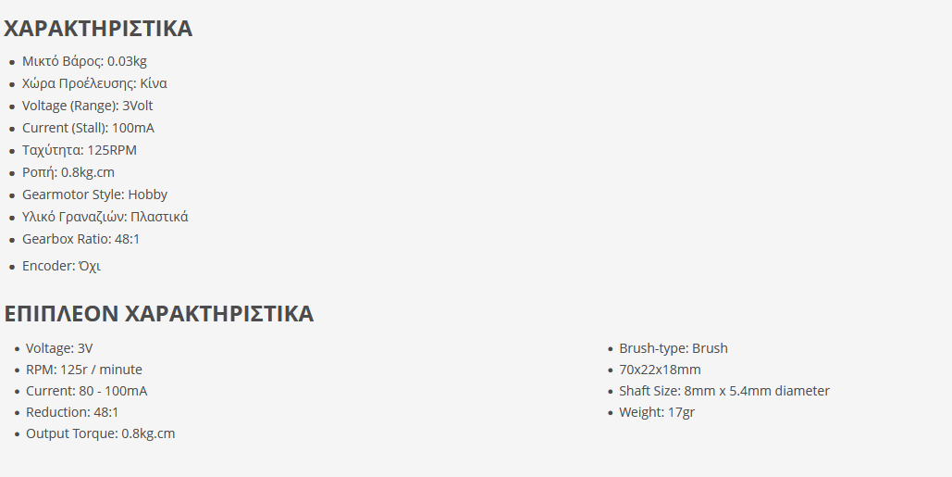
Project/Images/DC Motor/Χαρακτηριστικά DC Κινητήρα.png
