GeoKrom/NTUA-Mechatronic-Systems-course/Project/Images/DC Motor/Χαρακτηριστικά Driver.png

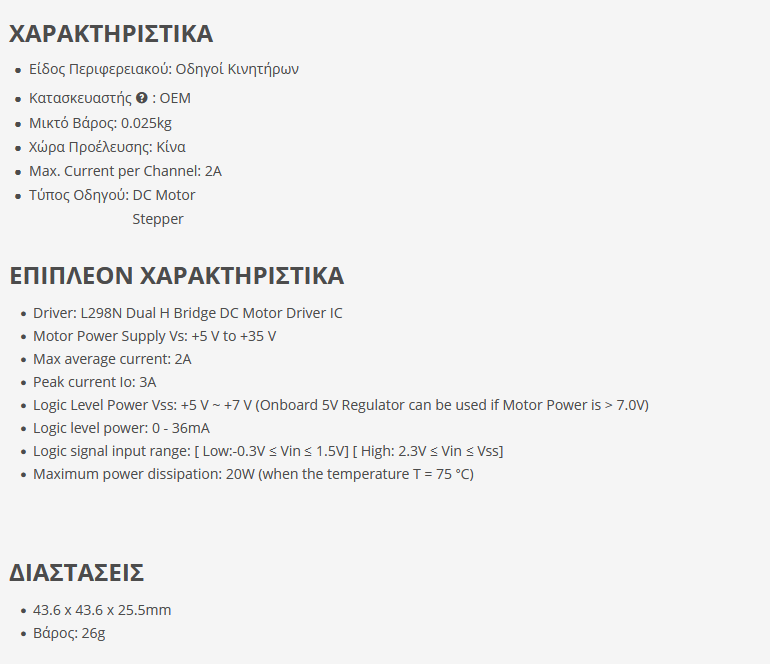
Project/Images/DC Motor/Χαρακτηριστικά Driver.png
