GeoKrom/NTUA-Mechatronic-Systems-course/Project/Images/Main Body/p0007920_new_com1_grobo.jpg

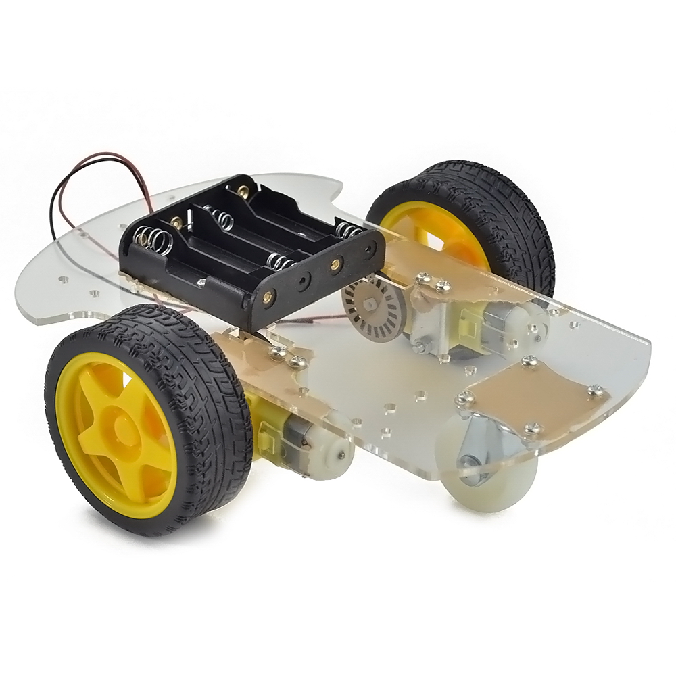
Project/Images/Main Body/p0007920_new_com1_grobo.jpg
