GeoKrom/NTUA-Mechatronic-Systems-course/Project/Images/Main Body/robot_smart_2wd_grobo.jpg

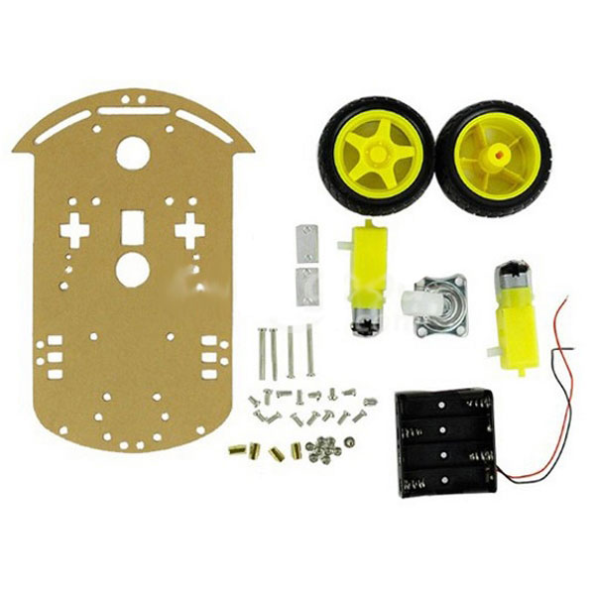
Project/Images/Main Body/robot_smart_2wd_grobo.jpg
