GeoKrom/NTUA-Mechatronic-Systems-course/Project/Images/Main Body/Χαρακτηριστικά Sassi.png

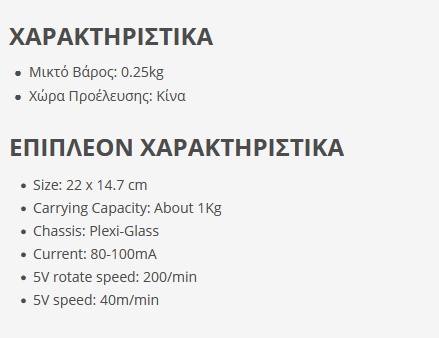
Project/Images/Main Body/Χαρακτηριστικά Sassi.png
