GeoKrom/NTUA-Mechatronic-Systems-course/Project/Images/Microntroller/Χαρακτηριστικά Arduino.png

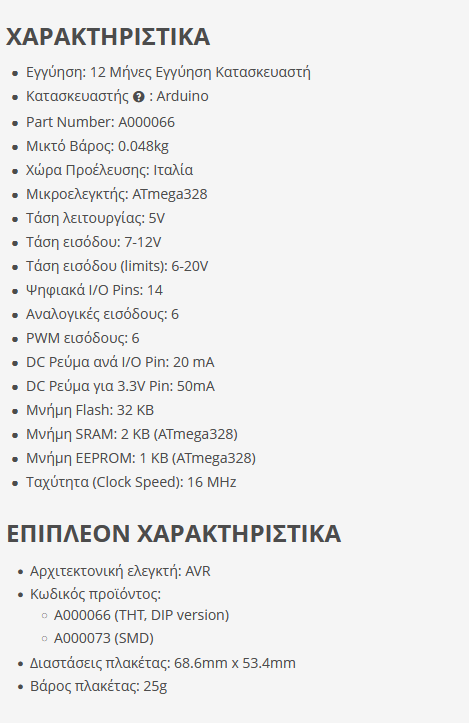
Project/Images/Microntroller/Χαρακτηριστικά Arduino.png
