GeoKrom/NTUA-Mechatronic-Systems-course/Project/Images/Modelling/pid_control.png

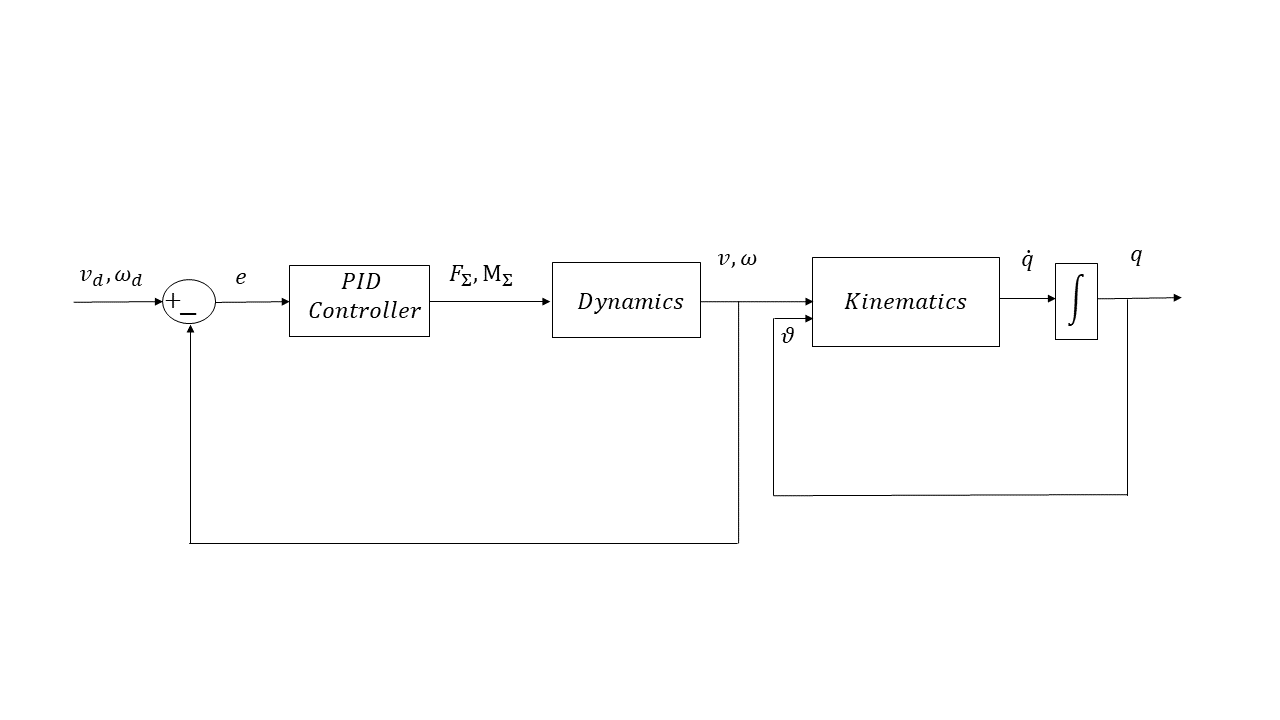
Project/Images/Modelling/pid_control.png
