GeoKrom/NTUA-Mechatronic-Systems-course/Project/Images/Sensors/photo-interrupter-sensor-3_grobo.jpg

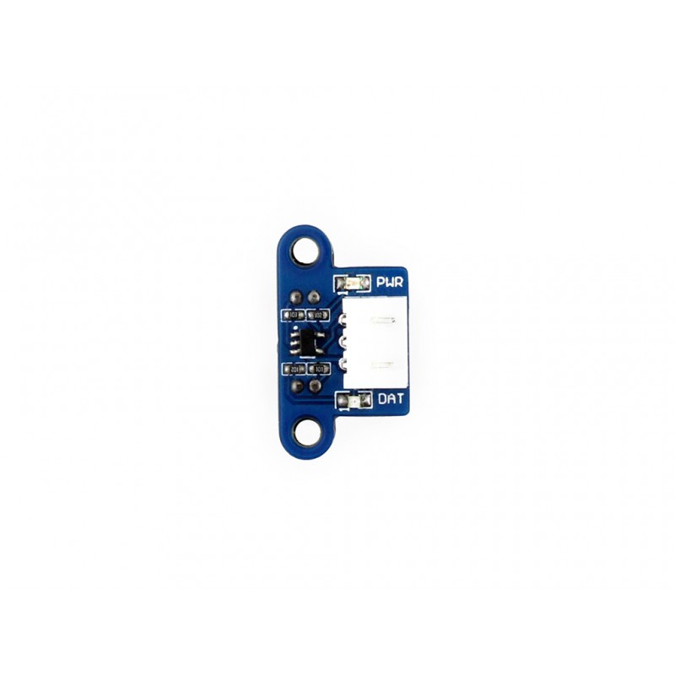
Project/Images/Sensors/photo-interrupter-sensor-3_grobo.jpg
