GeoKrom/NTUA-Mechatronic-Systems-course/Project/Images/Sensors/Photo-Interrupter-Sensor-size.jpg

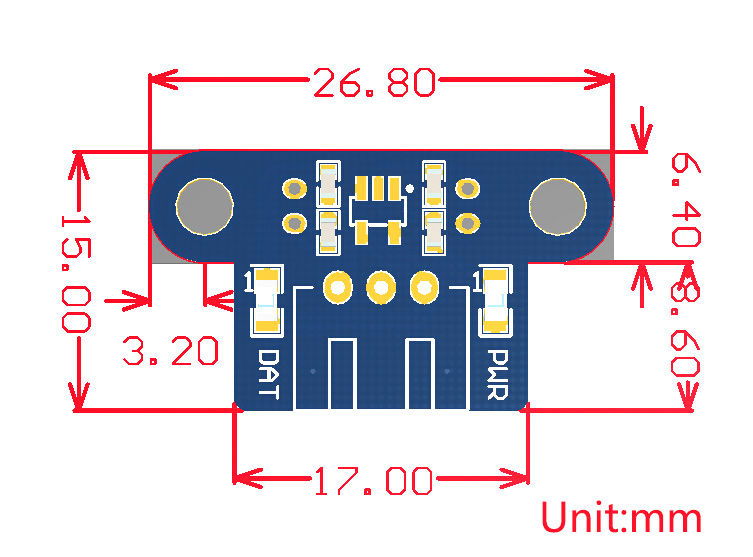
Project/Images/Sensors/Photo-Interrupter-Sensor-size.jpg
