GeoKrom/NTUA-Mechatronic-Systems-course/Project/Images/Sensors/Χαρακτηριστικά Encoder.png

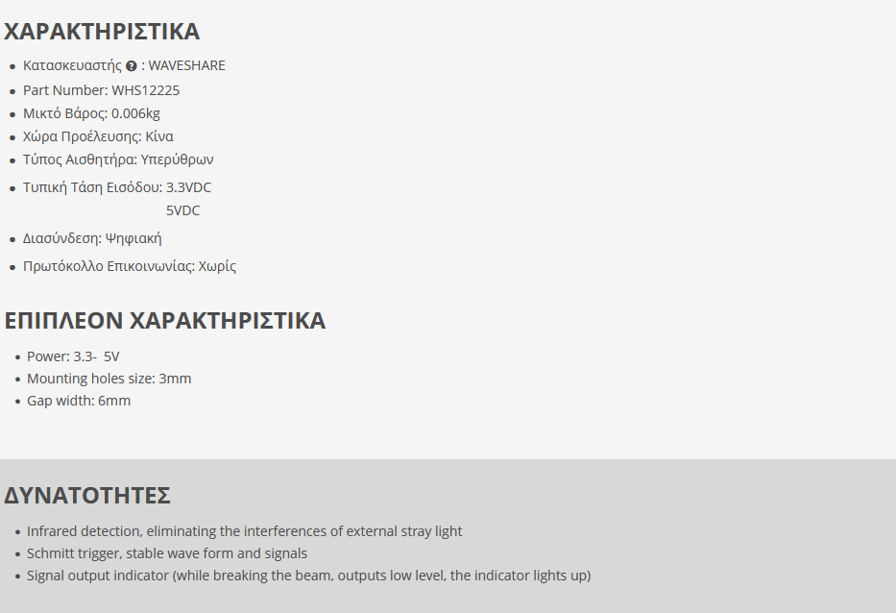
Project/Images/Sensors/Χαρακτηριστικά Encoder.png
