GeoKrom/NTUA-Mechatronic-Systems-course/Project/Images/Sensors/Χαρακτηριστικά Sonar.png

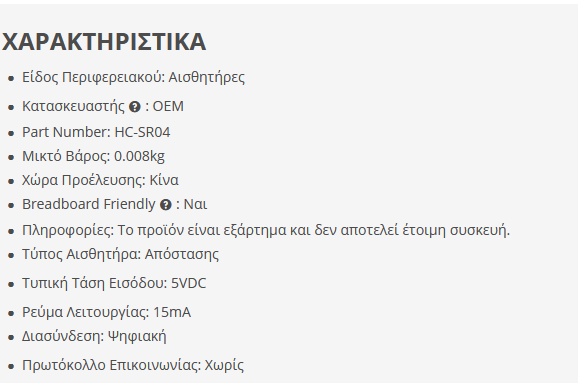
Project/Images/Sensors/Χαρακτηριστικά Sonar.png
