GeoKrom/NTUA-Mechatronic-Systems-course/Project/Images/Ρομποτικός_Βραχίονας_1.jpg

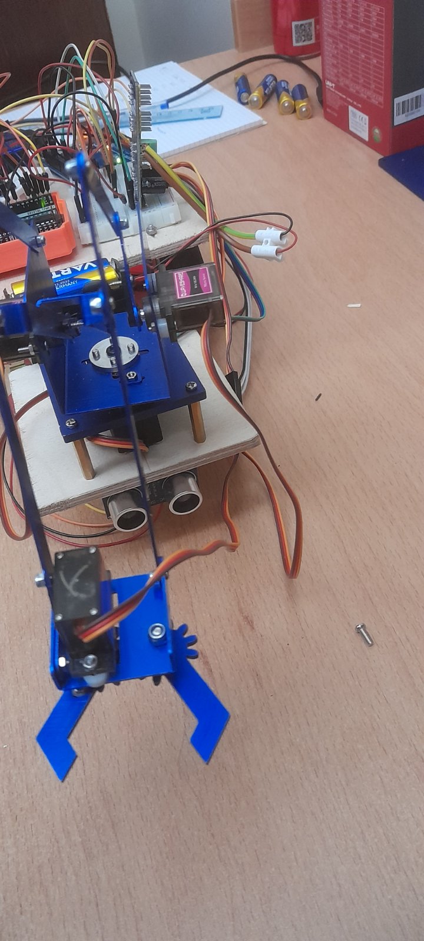
Project/Images/Ρομποτικός_Βραχίονας_1.jpg
