GeoKrom/NTUA-Mechatronic-Systems-course/Project/Images/Ρομποτικός_Βραχίονας_2.jpg

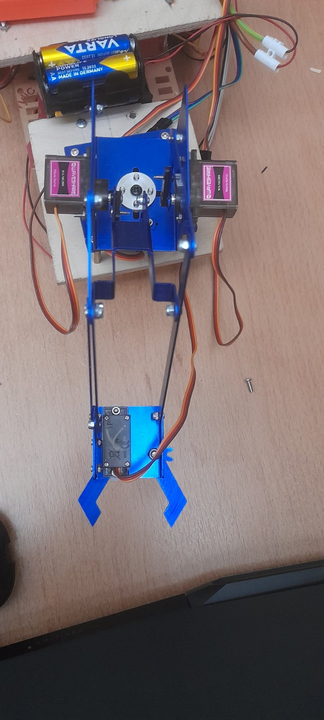
Project/Images/Ρομποτικός_Βραχίονας_2.jpg
