GeoKrom/NTUA-Mechatronic-Systems-course/Project/Images/Συνολική_Διάταξη_Κινητού_Βραχίονα_1.jpg

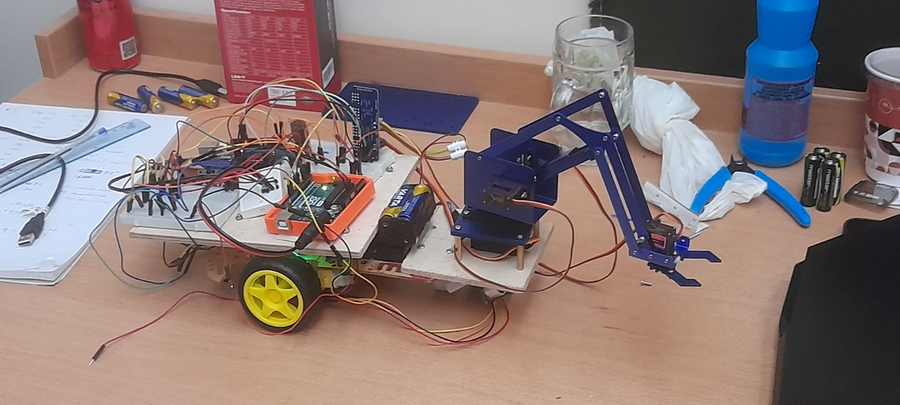
Project/Images/Συνολική_Διάταξη_Κινητού_Βραχίονα_1.jpg
