GeoKrom/NTUA-Mechatronic-Systems-course/Project/Images/Συνολική_Διάταξη_Κινητού_Βραχίονα_1_2.jpg

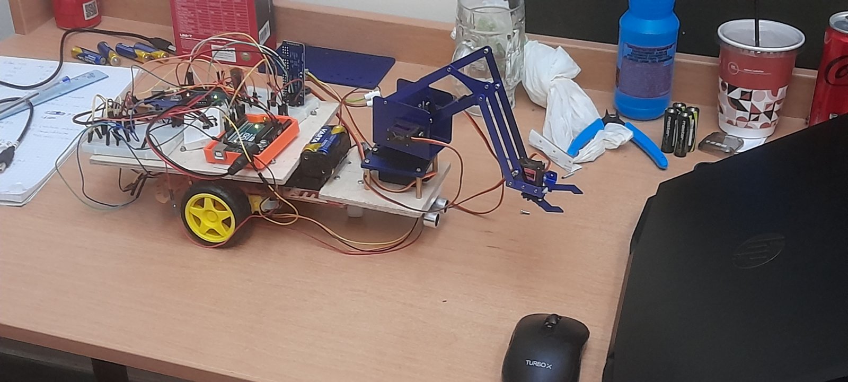
Project/Images/Συνολική_Διάταξη_Κινητού_Βραχίονα_1_2.jpg
