GeoKrom/NTUA-Mechatronic-Systems-course/Project/Images/Συνολική_Διάταξη_Κινητού_Βραχίονα_3.jpg

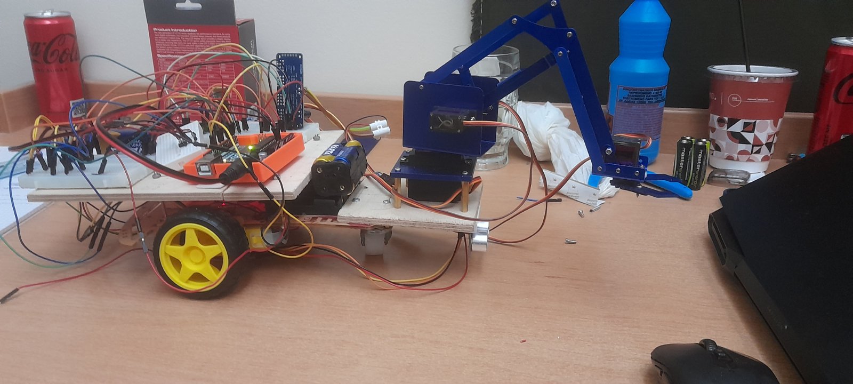
Project/Images/Συνολική_Διάταξη_Κινητού_Βραχίονα_3.jpg
