GeoKrom/NTUA-Mechatronic-Systems-course/Project/Images/Τροχοφόρο_1.jpg

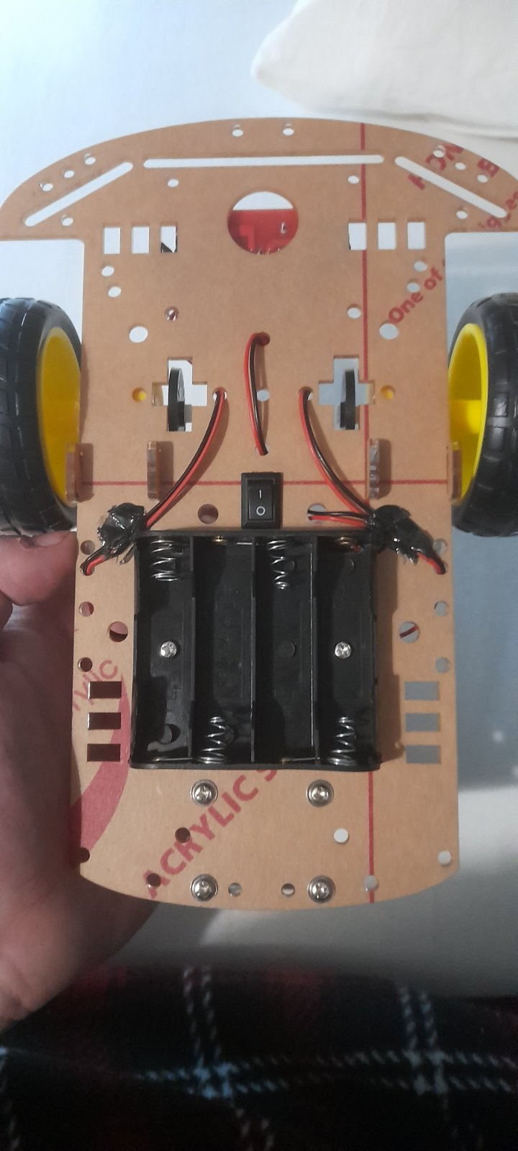
Project/Images/Τροχοφόρο_1.jpg
