GeoKrom/NTUA-Mechatronic-Systems-course/Project/Images/Τροχοφόρο_2.jpg

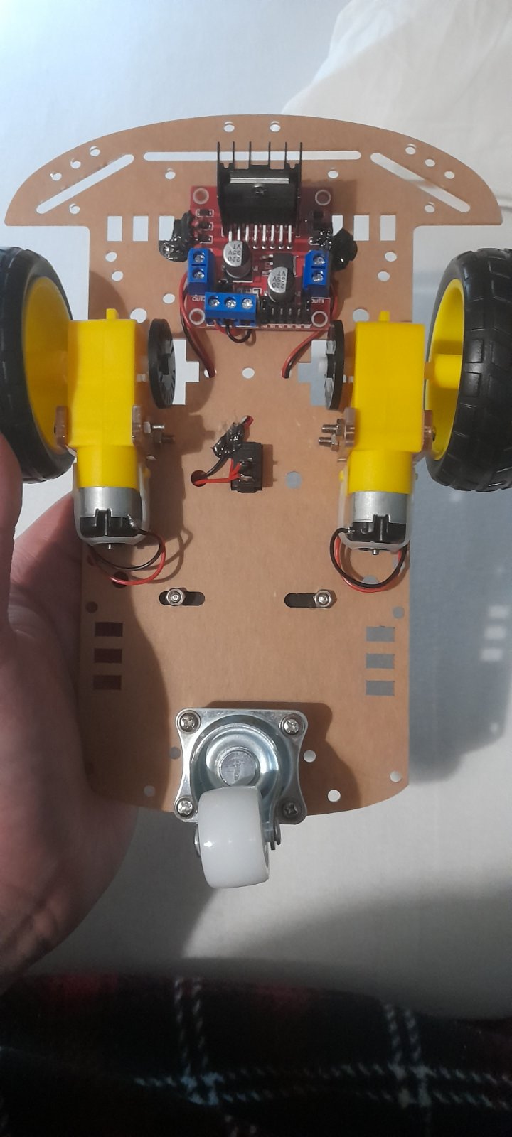
Project/Images/Τροχοφόρο_2.jpg
