GeoKrom/NTUA-Mechatronic-Systems-course/Project/Images/Χειριστήριο_1.jpg

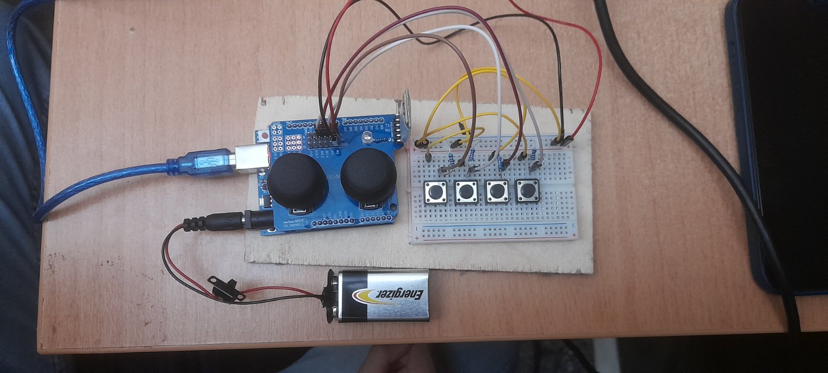
Project/Images/Χειριστήριο_1.jpg
