GeoKrom/NTUA-Mechatronic-Systems-course/Project/Images/Χειριστήριο_2.jpg

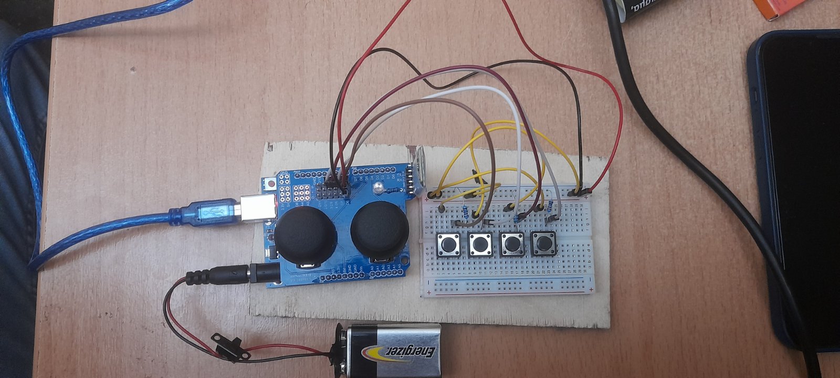
Project/Images/Χειριστήριο_2.jpg
