GeoKrom/NTUA-Mechatronic-Systems-course/Project/Images/Χειριστήριο_3.jpg

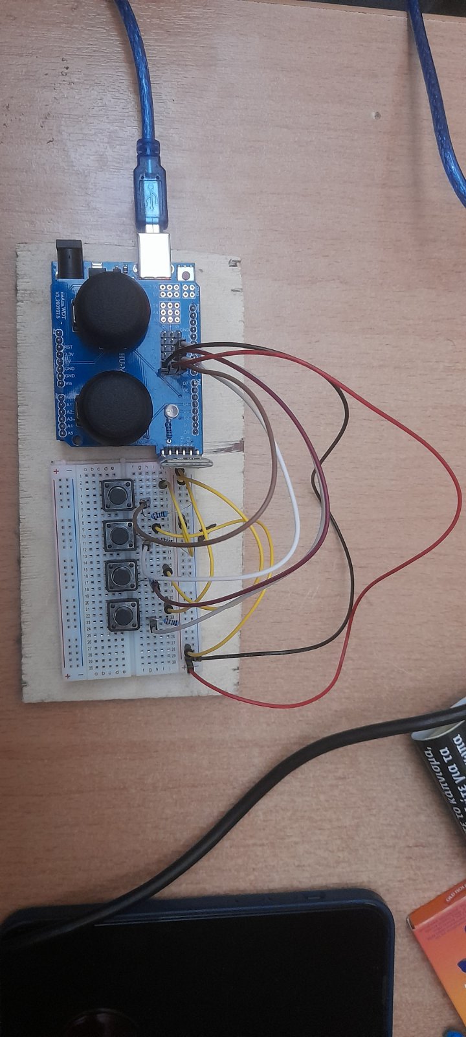
Project/Images/Χειριστήριο_3.jpg
