GeoKrom/NTUA-Mechatronic-Systems-course/Project/Images/Χειριστήριο_4.jpg

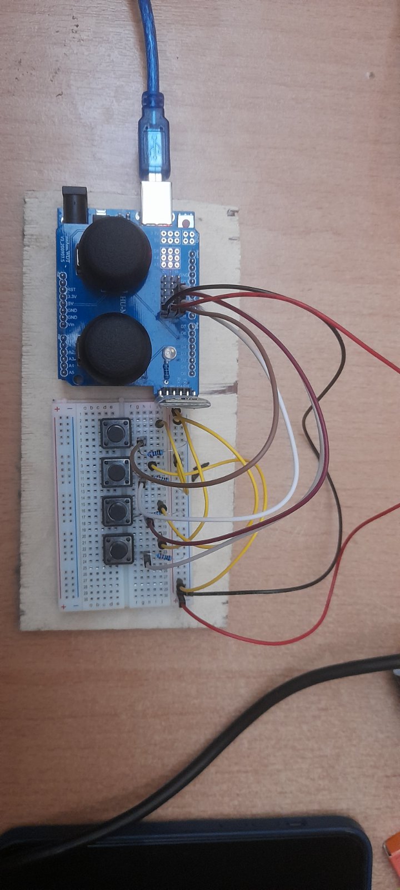
Project/Images/Χειριστήριο_4.jpg
