GeoKrom/NTUA-Mechatronic-Systems-course/Project/Images/Simulations/Dynamic Simulation/Gen_Vel_Step_Input.png

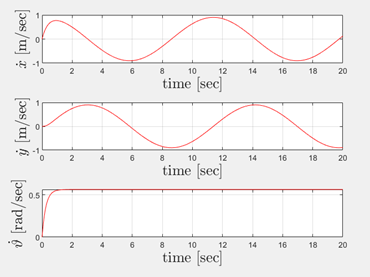
Project/Images/Simulations/Dynamic Simulation/Gen_Vel_Step_Input.png
