GeoKrom/NTUA-Mechatronic-Systems-course/Project/Images/Simulations/Dynamic Simulation/Lin_Vel_Step_Input.png

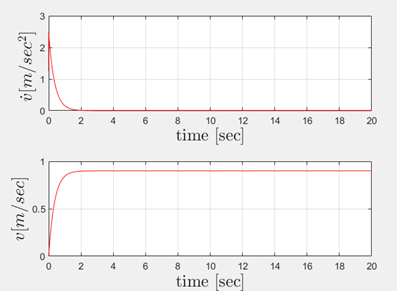
Project/Images/Simulations/Dynamic Simulation/Lin_Vel_Step_Input.png
