GeoKrom/NTUA-Mechatronic-Systems-course/Project/Images/Simulations/PID Control/Cartesian_Motion_PID_Step_Input.png

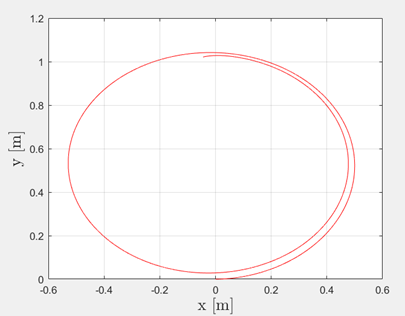
Project/Images/Simulations/PID Control/Cartesian_Motion_PID_Step_Input.png
