GeoKrom/NTUA-Mechatronic-Systems-course/Project/Images/Simulations/PID Control/Gen_Pos_PID_Step_Input.png

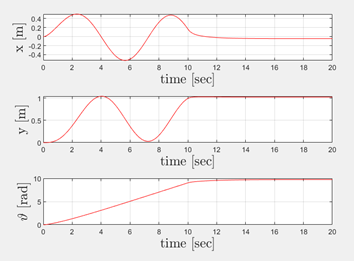
Project/Images/Simulations/PID Control/Gen_Pos_PID_Step_Input.png
