GeoKrom/NTUA-Mechatronic-Systems-course/Project/Images/Simulations/PID Control/Lin_Vel_PID_Step_Input.png

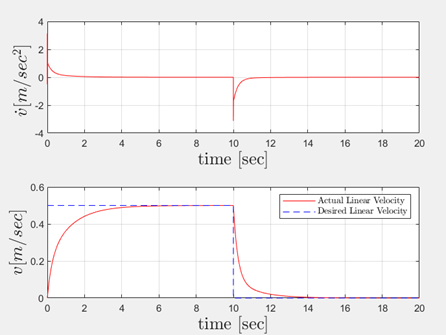
Project/Images/Simulations/PID Control/Lin_Vel_PID_Step_Input.png
