GeoKrom/NTUA-Mechatronic-Systems-course/Exercises/Exercise-1/Simulation Results/linear velocity result ode.png

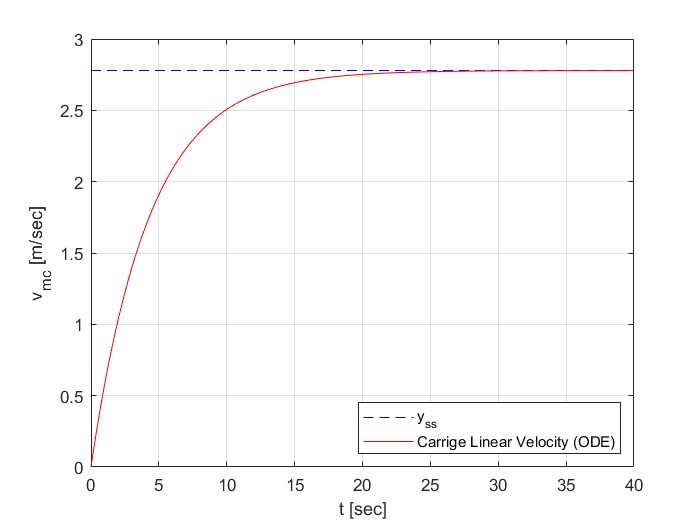
Exercises/Exercise-1/Simulation Results/linear velocity result ode.png
