GeoKrom/NTUA-Mechatronic-Systems-course/Exercises/Exercise-1/Simulation Results/root locus.png

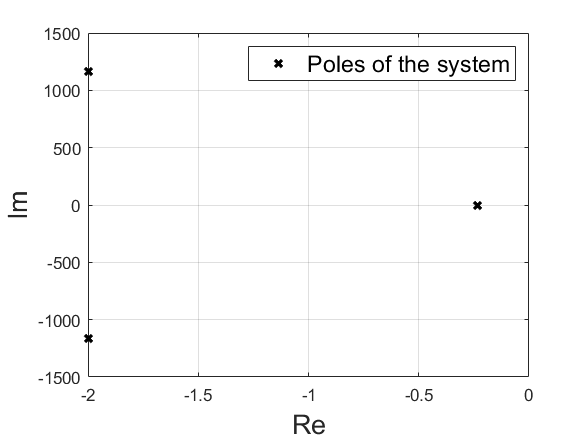
Exercises/Exercise-1/Simulation Results/root locus.png
