GeoKrom/NTUA-Mechatronic-Systems-course/Exercises/Exercise-1/Simulation Results/State Vector Results.png

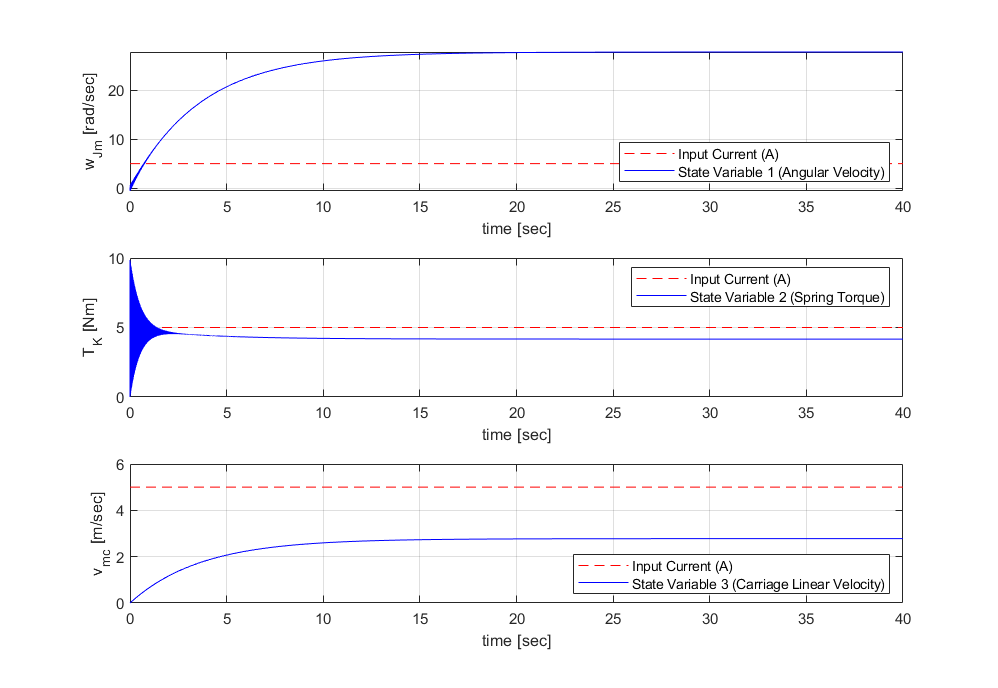
Exercises/Exercise-1/Simulation Results/State Vector Results.png
