GeoKrom/NTUA-Mechatronic-Systems-course/Exercises/Exercise-2/Simulation Results/Poles System 2.png

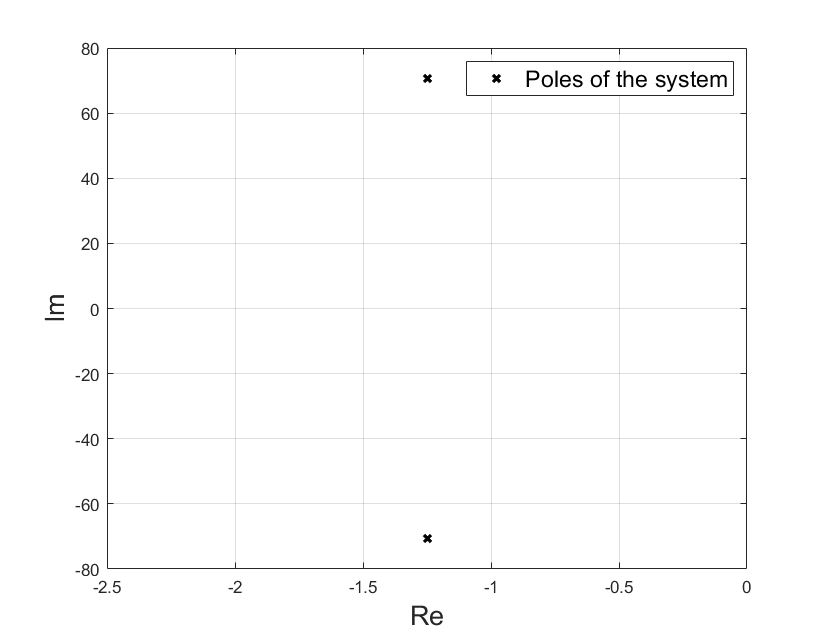
Exercises/Exercise-2/Simulation Results/Poles System 2.png
