GeoKrom/NTUA-Mechatronic-Systems-course/Exercises/Exercise-2/Simulation Results/Poles System.png

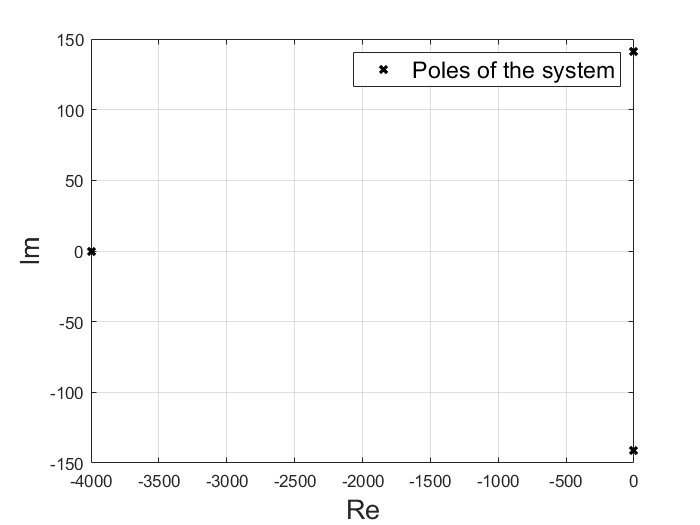
Exercises/Exercise-2/Simulation Results/Poles System.png
