GeoKrom/NTUA-Mechatronic-Systems-course/Exercises/Exercise-2/Simulation Results/Poles System_2.png

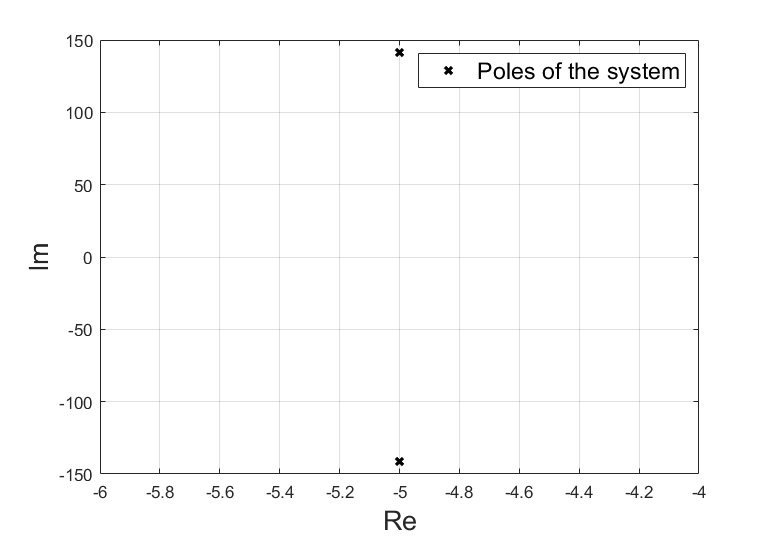
Exercises/Exercise-2/Simulation Results/Poles System_2.png
