GeoKrom/NTUA-Mechatronic-Systems-course/Exercises/Exercise-2/Simulation Results/State_Space_vector for input 2.5A.png

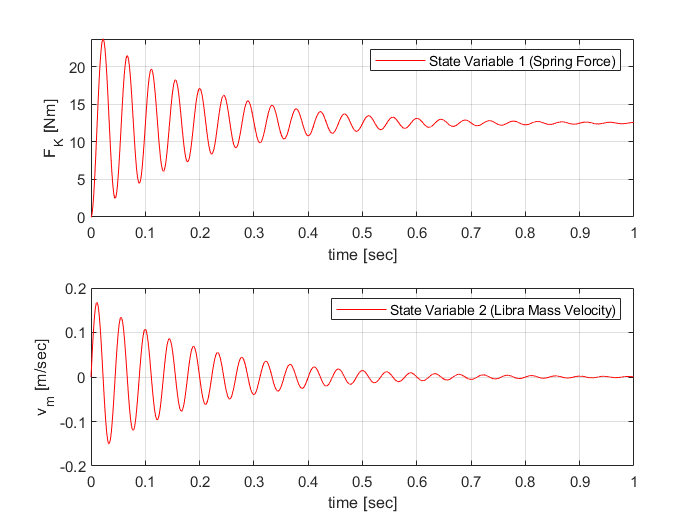
Exercises/Exercise-2/Simulation Results/State_Space_vector for input 2.5A.png
