GeoKrom/NTUA-Mechatronic-Systems-course/Exercises/Exercise-2/Simulation Results/State_Space_vector for input 10V.png

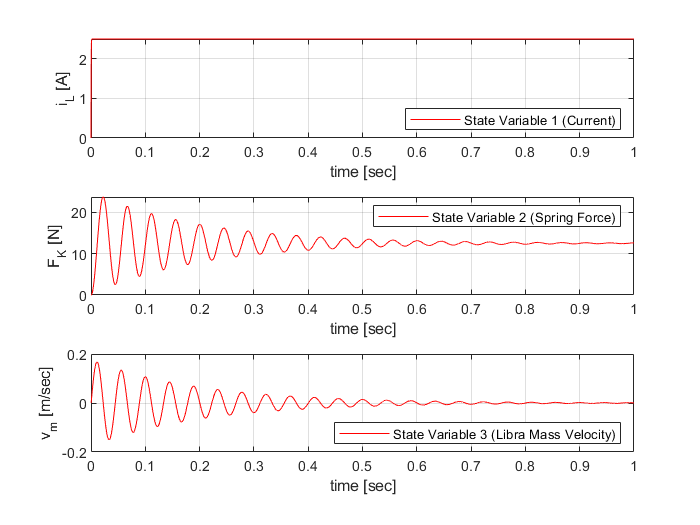
Exercises/Exercise-2/Simulation Results/State_Space_vector for input 10V.png
