GeoKrom/NTUA-Mechatronic-Systems-course/Project/Images/DC Motor/Characteristic_T_ω_DC_Motor.png

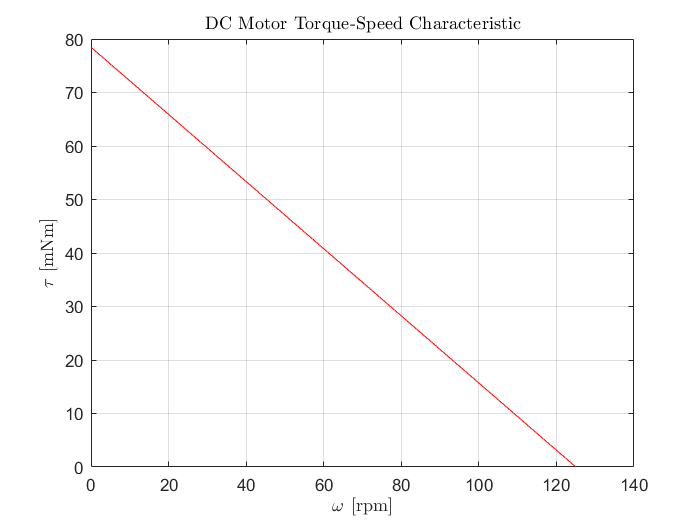
Project/Images/DC Motor/Characteristic_T_ω_DC_Motor.png
